fransschreuder/usbpicprog/trunk/mechanical/usbpicprog_case_bottom.stl

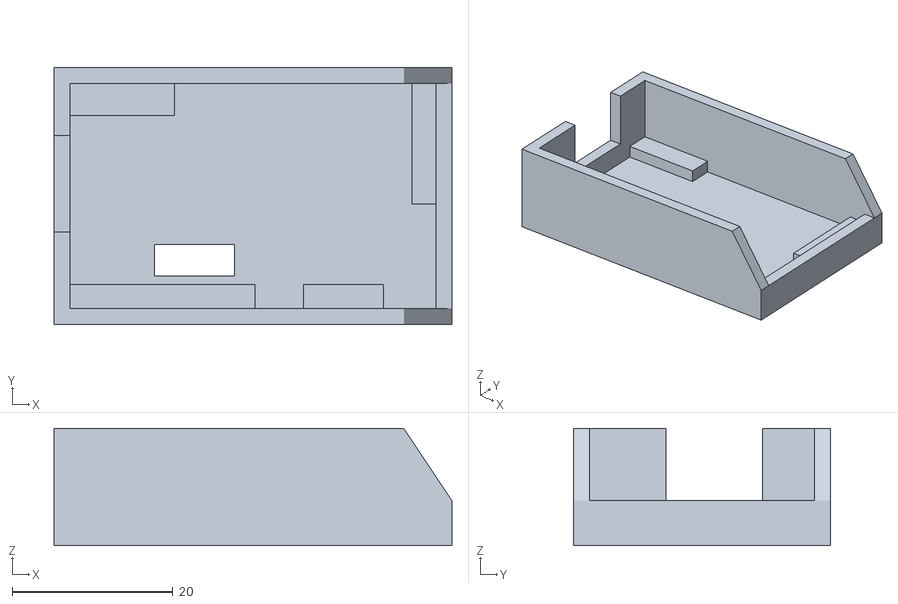
[picture p1: CAD file, 2012-11-05]
trunk/mechanical/usbpicprog_case_bottom.stl
49.5 x 32.0 x 14.6
