fransschreuder/usbpicprog/trunk/mechanical/usbpicprog_case_top.stl

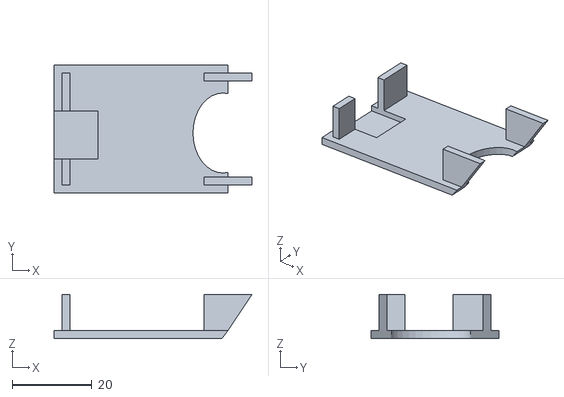
[picture p2: CAD file, 2012-11-05]
trunk/mechanical/usbpicprog_case_top.stl
49.5 x 32.0 x 11.0
