fransschreuder/usbpicprog/(threads)

Thread 8 (2014-11-26):

Error when verifying

diegoherranz, 2014-11-26:
I have an HEX file for PIC18F2550 which includes code and config (not data eeprom). Any kind of code/data/config protection is disabled.

I program the device with "Verify after programming" enabled and code, config and data verification enabled. The device is programmed correctly and the message is:
> Verify Successful

So far so good. However, if afterwards I press the "Verify" button, it fails saying:
>Verify config failed at 0x300000. Read: 0xFF, Expected: 0x00":

If I read the device back, the configration bits read are OK.

Doing some tests I noticed that the error only appears if you try to verify code and config at the same run. See this table:

| Verify Code | Verify Data | Verify Config | Result                                                       |
|:-----------:|:-----------:|:-------------:|:-------------------------------------------------------------|
|      NO     |      NO     |      YES      | Correct                                                      |
|      NO     |     YES     |       NO      | Correct                                                      |
|      NO     |     YES     |      YES      | Correct                                                      |
|     YES     |      NO     |       NO      | Correct                                                      |
|     YES     |      NO     |      YES      | Verify config failed at 0x300000. Read: 0xFF, Expected: 0x00 |
|     YES     |     YES     |       NO      | Correct                                                      |
|     YES     |     YES     |      YES      | Verify config failed at 0x300000. Read: 0xFF, Expected: 0x00 |

Then, I think that the first verification during programming works OK because code and data is verified first and config is verified later. ¿Right?

Do you have any clue where the problem is?

Thanks a lot!

PS: I noticed that using two different files, both having the same configuration bits but different code, only one of them shows this error while the other doesn't. So it seems that this bug is dependant of what's included in the code area.

PS2: usbpicprog 0.9.9-1.0.0-beta - 64 bit on Ubuntu GNOME 14.04 64 bits

diegoherranz, 2015-01-21:
Finally I had time to test with external power and everything works fine, no problems any more. So, it had to be something related with power.

It's surprising that depending on the HEX file it could fail or not.

From now on, I will always use external power.

Thanks for your help!

IMIKTechnology, 2016-06-23:
what is meant by USB error during verify

IMIKTechnology, 2016-06-23:
how i'm supposed to fix it ...?

fransschreuder, 2016-06-23:
Verify means that usbpicprog reads the code back that it just programmed, and checks it against what it just programmed. If the content doesn't match, it will tell you the address, the expected value and the read back value. It usually means that something went wrong.

IMIKTechnology, 2016-06-23:
i'm getting this error while flashing..

fransschreuder, 2016-06-23:
Of course you are, because "verify after programming" is enabled in settings.
Now what is your question?
What device are you programming?
Is your hardware normally working?

IMIKTechnology, 2016-06-23:
I'm using usbpicprog programmer...so while I try to flash i'm getting error as (USB error during verify) and also i'm getting another error followed by 1st one as (the hardware should say ok).I just want to know whether my programmer will work or not..

fransschreuder, 2016-06-23:
Ok, please just answer my questions and give some more detail as I requested. I can't help you like this.

IMIKTechnology, 2016-06-23:
i'm using usbpicprog by elementz pic programmer and flasher.http://elementzonline.com/usbpicprogrammer-by-elementz-pic-programmer-and-flasher-205?search=picprogrammer u can find in this website.I don't know whether it is working or not.When I try to burn my hex file i'm getting error what I mentioned above.

fransschreuder, 2016-06-23:
Elementz is a company that made their own board, based on usbpicprog but not the same. I had multiple questions about non-working elementz boards, and it seems crappy engineered to me.
Elementz is not at all related to usbpicprog, so please if you have malfunctioning hardware I would suggest you ask them to refund your money.
They are also violating the GPL by copying the hardware design, modifying it and not publishing the changes.

Closed 2015-01-21.

Thread 12 (2015-09-30):

Uncorrect command line

martinmikula, 2015-09-30:
I want to use a command line only interface, but it returns always 0 also in case when the command failure. (example: put wrong parameters, the program return value is 0 instead of some error code, and also a window with error appear instead of log the problem into console).

Thread 13 (2015-11-23):

Error when programming configuration bits

diegoherranz, 2015-11-23:
PIC: 18F25K22 (self-powered)
UPP sw: 0.9.9-1.0.0-beta-3
UPP fw: 1.0.0 P3
OS: Ubuntu 14.04 LTS

When loading the HEX file, on the Configuration Flags tab, I can see:

    CONFIG7L (30000Ch) = 00
    CONFIG7H (30000Dh) = 00

That means every EBTRx protection is enabled. Which is what I set on the code. So far so good.

When I try to program the device, I get an error:

    Verify config failed at 0x30000C. Read: 0x0F, Expected: 0x00

If I then read the device, the configuration flags tab says:

    CONFIG7L (30000Ch) = 0F
    CONFIG7H (30000Dh) = 40

Which confirms the error seen before.

Does it mean it isn't programming those two configuration bytes?

If I disable the EBTRx protections, it succeeds, but I guess it's because the default unprogrammed values for CONFIG7L and CONFIG7H happen to be what it's on the HEX file.

Many thanks!

Thread 16 (2018-05-31):

Slow communication

ilfirin-ms, 2018-05-31:
A have build usbpicprog v0.3hw, used 1.0.4fw and 1.0.5sw.
It's working, but painfully slow, five minutest to load and verify 117kB into PIC18F.
Looking into oscilloscope, clock are 300kHz, and communication is short (1-2ms) bursts of data at 60ms period at writing and even 100ms period at reading.
Is this normal behaviour?

Thank you

fransschreuder, 2018-05-31:
Hello ilfirin-ms.
I don't think I have often programmed a 117kB file into an 18F, but this is indeed to be expected if I scale a few seconds for a few kB .hex file to 117kB.
The PIC in the usbpicprog is not a very fast device, and probably also some of the firmware could be optimized. If you have ideas on how to improve things, your input is welcome.

ilfirin-ms, 2018-05-31:
fair enough

ilfirin-ms, 2018-06-07:
Thank you,

I wanted to use it as "independent programmer" for manufacture (to not Windows system), so commercial closed (Asix) and bloated and costy solutions (MPLAB) was not my target.

I did some research also (to build my own programmer based on your design). I would use some modern Arm chip, STM32F072, which has more power and especially, more RAM to buffer data.
Also SPI usage is important for xMHz clock, but there is a catch. I found, there have to be 20ns spaces between commands, data and more commands. This alone will make huge slowdown. Yeah, it could be maybe faster, than your solution, but I feared it wouldn't be manufacture fast enough.

I am also out of time, so probably will not build it. If time allows, I would tried to make 1$_small_F072@48Mhz_16kB_ram version with USB-CDC ascii protocol (don't like idea of making raws usb packets), but also will have slowdown with ascii translation, i know. If it would be not fast enought, port it to 10$_large_F407@168MHz_96kB_ram. If this wouldn't be either fast enough, then I am lost.

fransschreuder, 2018-06-09:
Hello Mike,
I guess you are not the only one with other priorities. I have little kids now and they take a lot of time, plus a bunch of other projects.
If somebody with fresh ideas wants to work on usbpicprog, I can make you developer as well, and even give access to the website.
I don't believe the wxWidgets loop is the problem, as the whole hex file is programmed from one while loop that is executed in a thread. There is a huge overhead of the usb library though, and that may cause some of the latency. Most of the latency is caused by the internal usb library of the PIC18F2550. This must take most of the time. Using a larger data buffer would help, but unfortunately I was unable to make this larger than a few bytes (64) or else the firmware became unstable.
Another option is not to use a microcontroller at all, but investigate the speed of the FT2232H chip. It has JTAG, SPI, I2C and some other features as well as raw bitbanging. I don't know at what speed we can bitbang there, but it may be faster than the PIC18F2550.
In that case the PIC code should be ported to the PC application, but I don't see a problem there either.

diegoherranz, 2018-06-09:
I've been using the FT2232H with OpenOCD and it works quite nice.
It's probably faster than the PIC18F2550, but I can't say for certain.

mafheldt, 2018-06-09:
Franz,

Congratulations!!! - there is nothing like kids to occupy every waking -
and sleeping! - moment.

The problem with the thread in WxWidgets is that although it was specified
to run on interrupt/realtime when it waited for the USB response from the
PIC it would wait 50ms (I spent some time trying to get around that in
2013).
I got around that but changing the protocol to send multiple 64 byte
packets to the programmer before expecting a response - that sped things up
greatly - BUT I only did it for the dsPICs/PIC24s as they were the only big
chips back then.

The PIC was not a big problem, but I sped up the programming by tweaking
the bit bang code and pretty well maxed out the programming speed. In my
email I sent I said it was 6 times faster overall - I don't remember if
that code was ever pulled into the system code, but it must still be in my
github clone of the code.

I am pretty sure that the limit at this point is the programming protocol
to the target PIC. Microchip added an "executive" are to many of the large
chips where it downloads a program, that then reads only the data from the
programmer (the current protocol is actually sending instructions and data
to the target PIC) and this would speed it up greatly

Of course these days one can buy a pickit 3 for 10 EUR on ebay.

mike

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

fransschreuder, 2018-06-09:
True, because of the price of the chinese programmers, and the availability of mplabx for linux, usbpicprog has lost quite some relevance.

mafheldt, 2018-06-09:
I have a pickit 3, mplabx is pretty crappy - but it does have breakpoints,
but I still use my usbpicprog!
I am right now updating my solar power charger for my boat and I'm using
your usbpicprog, it was a great little product

all the best
mike

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

Closed 2018-05-31.
