fransschreuder/usbpicprog/trunk/pcb/usbpicprog.pdf

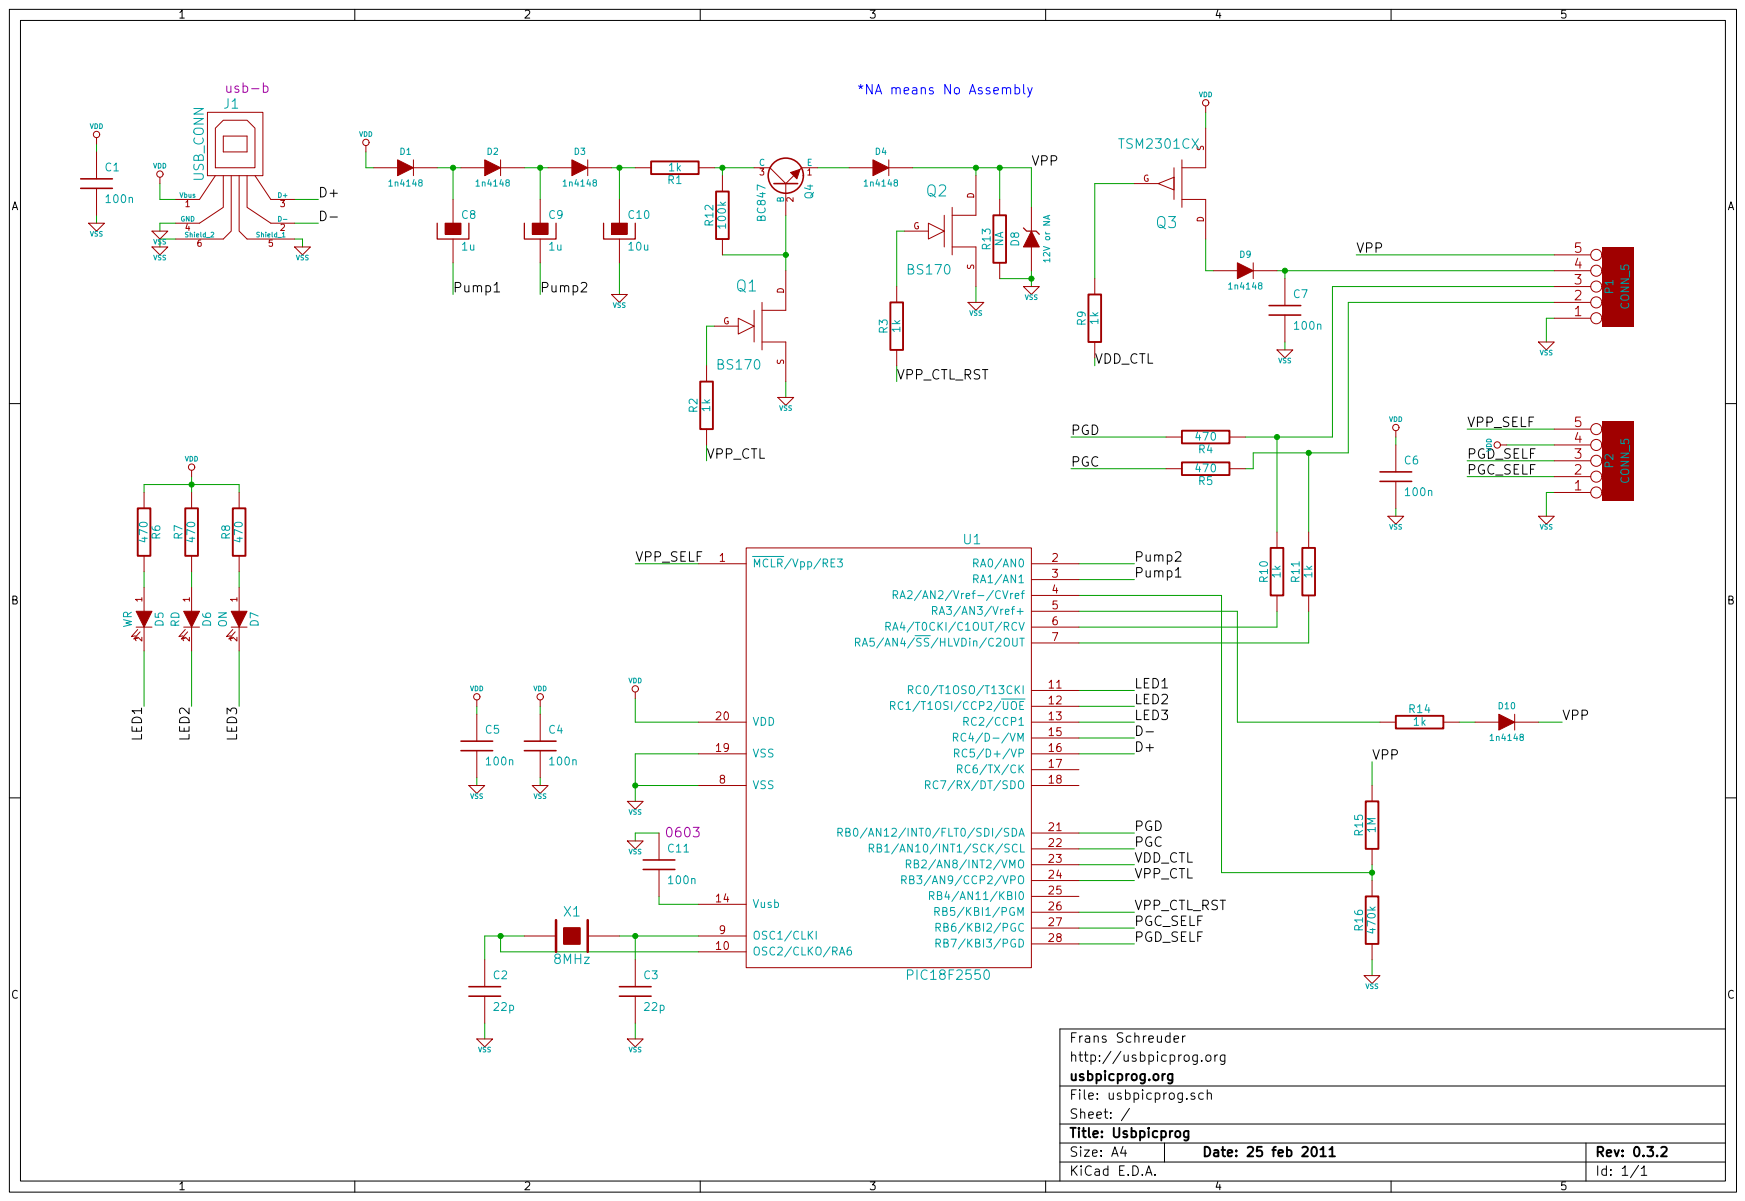
[picture p3: page 1]
