fransschreuder/usbpicprog/trunk/pcb/usbpicprog_th.pdf

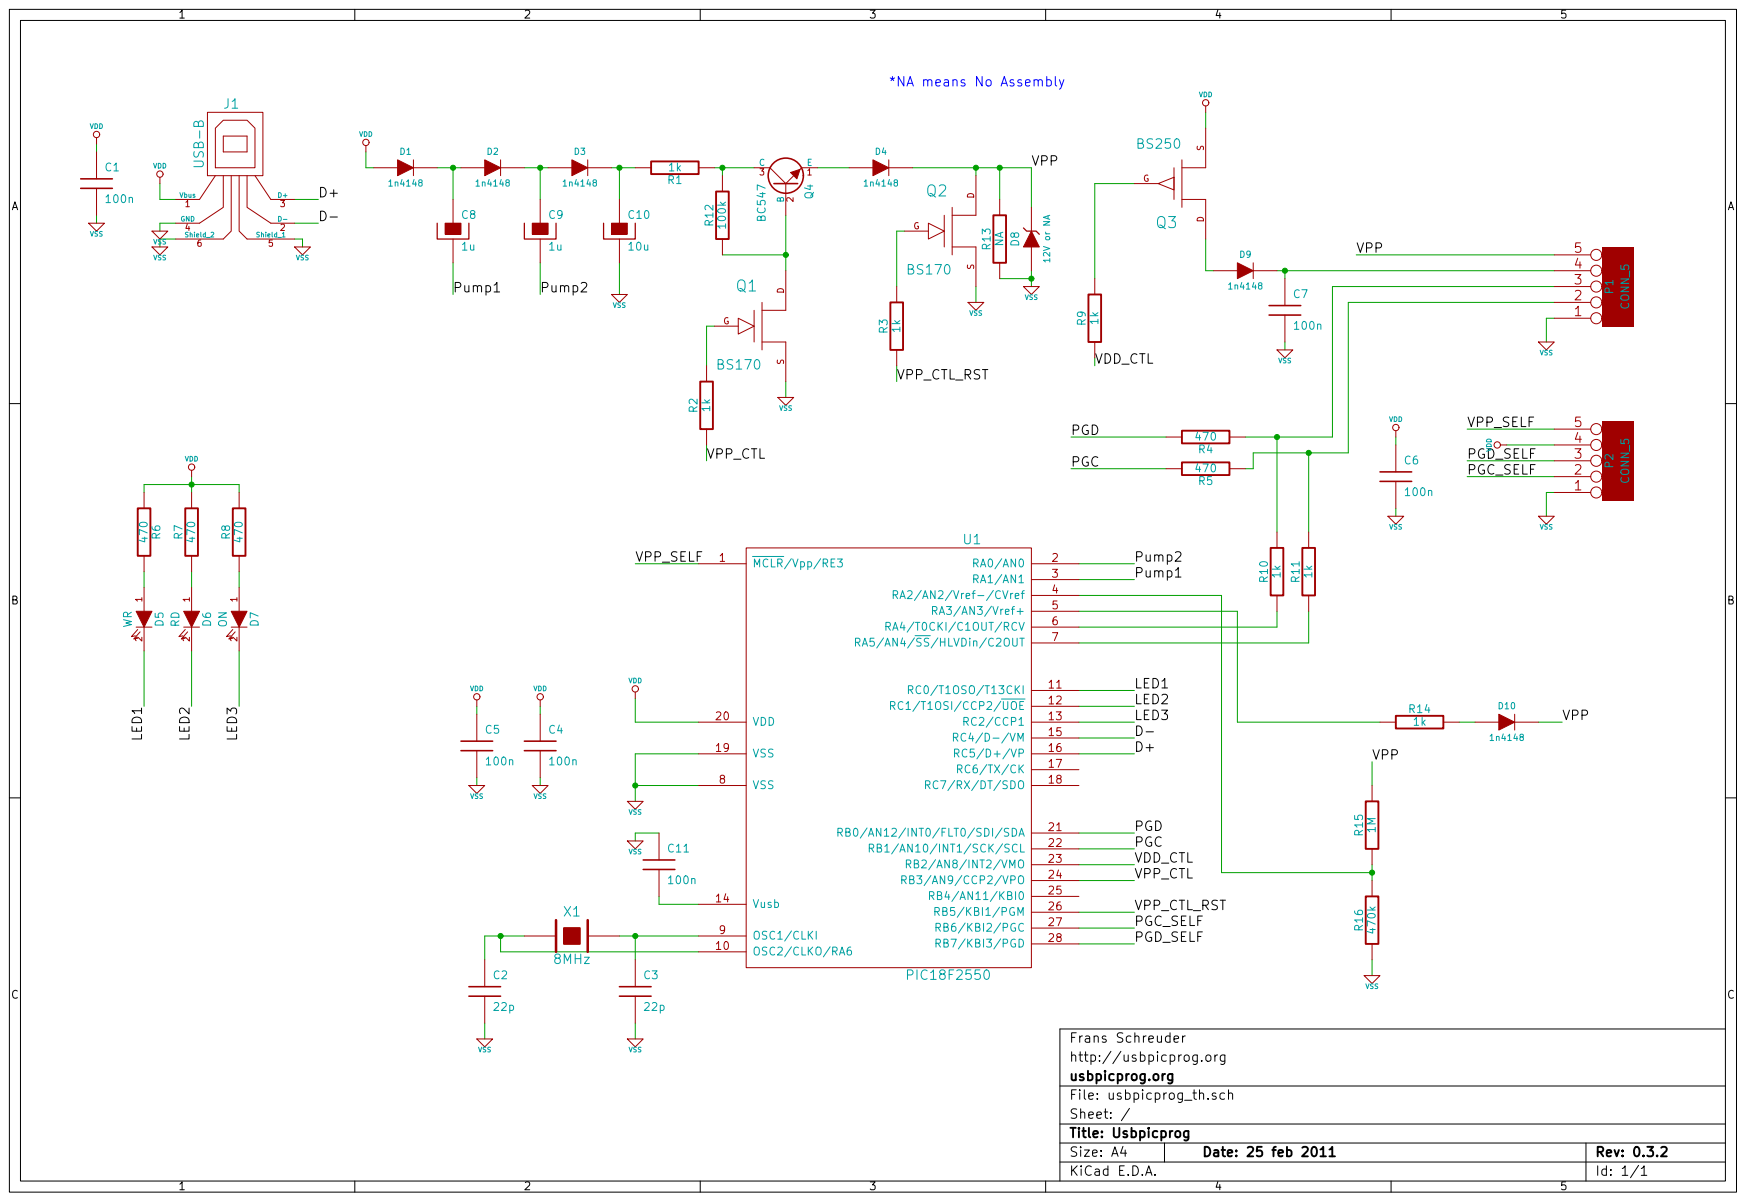
[picture p4: page 1]
