fransschreuder/usbpicprog/trunk/pcb/usbpicprog.sch

## KiCad design trunk/pcb/usbpicprog.sch (2013-02-21, an earlier design)

Schematic: usbpicprog.sch

Parts:
C1, C4, C5, C6, C7: 100n
C2, C3: 22p
C8, C9: 1u
C10: 10u
C11: 100n; 0603
D1, D2, D3, D4, D9, D10: 1n4148
D5: WR
D6: RD
D7: ON
D8: 12V or NA
J1: USB_CONN; usb-b
P1, P2: CONN_5
Q1, Q2: BS170
Q3: TSM2301CX
Q4: BC847
R1, R2, R3, R9, R10, R11, R14: 1k
R4, R5, R6, R7, R8: 470
R12: 100k
R13: NA
R15: 1M
R16: 470k
U1: PIC18F2550
X1: 8MHz

Notes on the sheet:
*NA means No Assembly
