fransschreuder/usbpicprog/trunk/uc_code/upp.c

/**************************************************************************
 *   Copyright (C) 2008 by Frans Schreuder                                 *
 *   usbpicprog.sourceforge.net                                            *
 *                                                                         *
 *   This program is free software; you can redistribute it and/or modify  *
 *   it under the terms of the GNU General Public License as published by  *
 *   the Free Software Foundation; either version 2 of the License, or     *
 *   (at your option) any later version.                                   *
 *                                                                         *
 *   This program is distributed in the hope that it will be useful,       *
 *   but WITHOUT ANY WARRANTY; without even the implied warranty of        *
 *   MERCHANTABILITY or FITNESS FOR A PARTICULAR PURPOSE.  See the         *
 *   GNU General Public License for more details.                          *
 *                                                                         *
 *   You should have received a copy of the GNU General Public License     *
 *   along with this program; if not, write to the                         *
 *   Free Software Foundation, Inc.,                                       *
 *   59 Temple Place - Suite 330, Boston, MA  02111-1307, USA.             *
 **************************************************************************/

#ifdef __XC8
#include <xc.h>
#elif defined(SDCC)
#include <pic18f2550.h>
#else
#include <p18cxxx.h>
#endif

#include "typedefs.h"
#include "usb.h"

#include "io_cfg.h"             // I/O pin mapping
#include "upp.h"
#include <string.h>
#include "prog.h"
#include "prog_lolvl.h"
#include "svn_revision.h"
#include "interrupt.h"
#include "main.h"
#include "debug_link.h"

/** V A R I A B L E S ********************************************************/
#ifndef SDCC
#pragma udata
#endif
byte old_sw2, old_sw3;

// FIXME: why 0x100?
#pragma udata BUFFERS=0x100

byte input_buffer[USBGEN_EP_SIZE];
byte output_buffer[USBGEN_EP_SIZE];
#pragma udata

extern unsigned char ConfigDisableVDD;
extern unsigned char ConfigLimitVPP;
extern unsigned char ConfigLimitPGDPGC;

rom char upp_version[] = {
		SVN_REVISION };

// Programming mode is left after this long without a command from the host.
// Within a session the host sends its blocks back to back, and the timer is
// restarted after every command, so slow commands (erase, word-by-word
// writes) don't count towards it.
#define ISCP_IDLE_TIMEOUT_MS	5000

/** P R I V A T E  P R O T O T Y P E S ***************************************/
void BlinkUSBStatus( void );
BOOL Switch2IsPressed( void );
BOOL block_size_ok( int nBytes );

void setLeds( char n );

/** D E C L A R A T I O N S **************************************************/
#ifndef SDCC
#pragma code
#endif

void InitAdc( void )
{
	ADCON0 = 0x09; //Enable AD converter to Channel AN2 (measure VPP);
	ADCON2 = 0xA6; //0x88		//Right justified, 2TAD, Fosc/2
	ADCON1 = 0x0F; //All signals to Digital
	TRISAbits.TRISA2 = 1; //Input;
}

void ReadAdc( unsigned char* data )
{
	char i;
	i = 0;
	ADCON1 = 0x0C; //channel AN2 .. AN0 to analog
	ADCON0bits.GO = 1;
	while( ADCON0bits.GO )
		continue;//||(i++<100))continue;
	data[0] = ADRESL;
	data[1] = ADRESH;
	ADCON1 = 0xFF; //back to digital...
}

void UserInit( void )
{
	mInitAllLEDs();
	mInitAllSwitches();
	InitAdc();
	old_sw2 = sw2;
	Pump1tris = 0;
	Pump2tris = 0;

	TRISVPP = 0; //output
	TRISVPP_RST = 0; //output
	TRISPGD = 0;
	TRISPGC = 0;
	TRISVDD = 0;
	TRISVPP_RUN = 0;
	VPP_RUN = 0; //run = off
	PGD_LOW = 0;	// always set to 0 -except for I2C EEproms
	TRISPGD_LOW = 1; //LV devices disabled, high impedance / input
	PGC_LOW = 0;	// always set to 0
	TRISPGC_LOW = 1; //LV devices disabled, high impedance / input
	VPP = 1; //VPP is low (inverted)
	VPP_RST = 0; //No hard reset (inverted
	PGD = 0;
	PGC = 0;
	INTCON2bits.RBPU = 1; //disable Portb pullup resistors
	timer1Init();
	timer0Init();
}//end UserInit

void timer1Init( void )
{
	INTCON |= 0xC0; //global and periferal interrupts enabled
	PIE1bits.TMR1IE = 1;//enable timer1 interrupt
	PIR1bits.TMR1IF = 0;//clear interrupt flag
	IPR1bits.TMR1IP = 1;//high priority interrupt
	TMR1H = TMR1H_PRESET;
	TMR1L = TMR1L_PRESET;
	T1CON = 0x01; //timer1 on, prescaler 1;1, internal clock
}

void timer0Init( void )
{
	INTCON |= 0xE0; //global, periferal and t0ie bits enabled
	INTCONbits.TMR0IF = 0; //clear interrupt flag
	TMR0L = 68;//TMR0L_PRESET;
	T0CON = 0xC3; //prescaler div by 1:16
}

void setLeds( char n )
{
	mLED_1 = ~(n & 1);
	mLED_2 = ~((n & 2) >> 1);
	mLED_3 = ~((n & 4) >> 2);
}

/******************************************************************************
 * Function:        void ProcessIO(void)
 *
 * PreCondition:    None
 *
 * Input:           None
 *
 * Output:          None
 *
 * Side Effects:    None
 *
 * Overview:        This function is a place holder for other user routines.
 *                  It is a mixture of both USB and non-USB tasks.
 *
 * Note:            None
 *****************************************************************************/

//unsigned int input_buffer_offset=0;

void ProcessIO( void )
{
	char oldPGDtris;
	char PIN;
	static byte counter = 0;
	int nBytes;
	unsigned long address;
	static int isReading = 0;
	unsigned int idle;

	// Leave programming mode when the host has abandoned a session (crashed,
	// timed out, unplugged from the PC side), instead of leaving VPP and VDD
	// on the target indefinitely.
	if( iscp_active )
	{
		INTCONbits.GIE = 0;	// read the ISR's 16-bit counter in one piece
		idle = idleMs;
		INTCONbits.GIE = 1;
		if( idle > ISCP_IDLE_TIMEOUT_MS )
		{
			exit_ISCP();
			isReading = 0;
		}
	}

	// When the device is plugged in, the leds give the numbers 1, 2, 3, 4, 5.
	//After configured state, the leds are controlled by the next lines in this function
	if( usb_device_state < CONFIGURED_STATE )
	{
		// A bus reset or deconfiguration ends the host's session: drop any
		// reply or multi-block read that belongs to it.
		counter = 0;
		isReading = 0;
	}
	if( (usb_device_state < CONFIGURED_STATE) || (UCONbits.SUSPND == 1) )
	{
		BlinkUSBStatus();
		return;
	}

	// Exactly one reply per command, in order: while the host has not taken
	// the previous reply, don't accept a new command (the OUT endpoint NAKs).
	// Dropping the reply instead made the host read every later reply one
	// command late.
	if( counter != 0 )
	{
		if( mUSBGenTxIsBusy() )
			return;
		USBGenWrite( (byte*) &output_buffer, counter );
		counter = 0;
	}

	nBytes = USBGenRead( (byte*) input_buffer, 64 );
	if( nBytes > 0 )
		isReading = 0;	// a new command ends an unfinished multi-block read
	if( nBytes == 0 && !mUSBGenTxIsBusy() && isReading
	 || nBytes > 0 )
	{
		idleMs = 0;	// the host is active (a command, or the next block of a multi-block read)
		if( nBytes > 0 && !block_size_ok( nBytes ) )
		{
			output_buffer[0] = 3;
			counter = 1;
		}
		else switch( input_buffer[0] ) {
		case CMD_GET_PROTOCOL_VERSION:
			output_buffer[0] = PROT_UPP;		// see upp.h
			counter = 1;
			break;
		case CMD_EXIT_TO_BOOTLOADER:
			exitToBootloader( 1 );		// if this returns -> bad bootloader version, return error
			// blink for 2s: stay under the host's 3s timeout so the error reply
			// arrives while the host is still waiting for it
			for( counter = 0; counter < 5; counter++ )
			{
				setLeds(7);
				DelayMs( 200 );
				setLeds( 0 );
				DelayMs( 200 );
			}
			output_buffer[0] = 3;
			counter = 1;
			break;
		case CMD_ERASE:
			setLeds( LEDS_ON | LEDS_WR );
			output_buffer[0] = bulk_erase( input_buffer[1] );
			counter = 1;
			setLeds( LEDS_ON );
			break;
		case CMD_READ_ID:
			setLeds( LEDS_ON | LEDS_RD );
			output_buffer[0] = 0;	// families without a device ID reply 0x0000
			output_buffer[1] = 0;
			switch( picfamily ) {
			case PIC24:
			case dsPIC30:
				read_code( 0xFF0000, (unsigned char*) output_buffer, 2, BLOCKTYPE_FIRST|BLOCKTYPE_LAST|BLOCKTYPE_CONFIG );
				break;
			case PIC18:
			case PIC18J:
			case PIC18K:
				//devid is at location 0x3ffffe   for PIC18 devices
				read_code( 0x3FFFFE, (unsigned char*) output_buffer, 2, BLOCKTYPE_FIRST|BLOCKTYPE_LAST|BLOCKTYPE_CONFIG );
				break;
			case PIC16:
				exit_ISCP();
				//devid is at location 0x2006  for PIC16 devices
				read_code( 0x2006, (unsigned char*) output_buffer, 2, BLOCKTYPE_FIRST|BLOCKTYPE_LAST|BLOCKTYPE_CONFIG );
				break;
			}
			counter = 2;
			setLeds( LEDS_ON );
			break;
		case CMD_WRITE_CODE:
			setLeds( LEDS_ON | LEDS_WR );
			address = ((unsigned long) input_buffer[2]) << 16 | ((unsigned long) input_buffer[3]) << 8
					| ((unsigned long) input_buffer[4]);
			output_buffer[0] = write_code( address,
					(unsigned char*) (input_buffer + 6), input_buffer[1], input_buffer[5] );
			counter = 1;
			setLeds( LEDS_ON );
			break;
		case CMD_READ_CONFIG:
			input_buffer[5] |= BLOCKTYPE_CONFIG;
			// no break
		case CMD_READ_CODE_OLD:
			if( input_buffer[1] <= 8 )		// this is correct for all but PIC18F4321(?) where it doesn't matter
				input_buffer[5] |= BLOCKTYPE_CONFIG;
		case CMD_READ_CODE:
			setLeds( LEDS_ON | LEDS_RD );

			address = ((unsigned long) input_buffer[2]) << 16 | ((unsigned long) input_buffer[3]) << 8
					| ((unsigned long) input_buffer[4]);
			read_code( address, (unsigned char*) output_buffer, input_buffer[1], input_buffer[5] );
			counter = input_buffer[1];
			setLeds( LEDS_ON );
			break;
        case CMD_MREAD_CODE:
            setLeds( LEDS_ON | LEDS_RD );

            address = ((unsigned long) input_buffer[2]) << 16 | ((unsigned long) input_buffer[3]) << 8
                    | ((unsigned long) input_buffer[4]);
            read_code( address, (unsigned char*) output_buffer, input_buffer[1], input_buffer[5] );
            if( --input_buffer[7] == 255 )
                --input_buffer[6];
            if( input_buffer[6] == 0 && input_buffer[7] == 0 )
                isReading = 0;
            else
                isReading = 1;
            if( picfamily == PIC10
             || picfamily == PIC12
             || picfamily == PIC16 )
                address += input_buffer[1]/2;
            else
                address += input_buffer[1];
            input_buffer[4] = address;
            input_buffer[3] = address >> 8;
            input_buffer[2] = address >>16;
            counter = input_buffer[1];
            setLeds( LEDS_ON );
            break;
		case CMD_WRITE_DATA:
			setLeds( LEDS_ON | LEDS_WR );
			address = ((unsigned long) input_buffer[2]) << 16 | ((unsigned long) input_buffer[3]) << 8
					| ((unsigned long) input_buffer[4]);
			output_buffer[0] = write_data( address,
					(unsigned char*) (input_buffer + 6), input_buffer[1], input_buffer[5] );
			counter = 1;
			setLeds( LEDS_ON );
			break;
		case CMD_READ_DATA:
			setLeds( LEDS_ON | LEDS_RD );
			address = ((unsigned long) input_buffer[2]) << 16 | ((unsigned long) input_buffer[3]) << 8
					| ((unsigned long) input_buffer[4]);
			read_data( address, (unsigned char*) output_buffer, input_buffer[1],
					input_buffer[5] );
			counter = input_buffer[1];
			setLeds( LEDS_ON );
			break;
		case CMD_WRITE_CONFIG:
			setLeds( LEDS_ON | LEDS_WR );
			address = ((unsigned long) input_buffer[2]) << 16 | ((unsigned long) input_buffer[3]) << 8
					| ((unsigned long) input_buffer[4]);
			output_buffer[0] = write_config_bits( address,
					(unsigned char*) (input_buffer + 6), input_buffer[1], input_buffer[5] );
			counter = 1;
			setLeds( LEDS_ON );
			break;
		case CMD_SET_PICTYPE:
		{
			int i;

			output_buffer[0] = set_pictype( input_buffer[1] );
			counter = 1;
			setLeds( LEDS_ON );
			break;
		}
		case CMD_FIRMWARE_VERSION:
#ifdef __XC8
			strcpy((char*)output_buffer,upp_version);
#else
			strcpypgm2ram((char*)output_buffer,(const far rom char*)upp_version);
#endif
			counter = 18;
			setLeds( LEDS_ON );

			break;
		case CMD_DEBUG:
			setLeds( LEDS_ON | LEDS_WR | LEDS_RD );
			switch( input_buffer[1] ) {
			case 0:
				set_pictype( dsP30F );
				enter_ISCP();
				output_buffer[0] = 1;
				counter = 1;
				break;
			case 1:
				exit_ISCP();
				output_buffer[0] = 1;
				counter = 1;
				break;
			case 2:
				dspic_send_24_bits( ((unsigned long) input_buffer[2])
						| ((unsigned long) input_buffer[3]) << 8
						| ((unsigned long) input_buffer[4]) << 16 );
				output_buffer[0] = 1;
				counter = 1;
				break;
			case 3:
				nBytes = dspic_read_16_bits( 1 );
				output_buffer[0] = (unsigned char) nBytes;
				output_buffer[1] = (unsigned char) (nBytes >> 8);
				counter = 2;
				break;
			default:
				output_buffer[0] = 3;
				counter = 1;
				break;
			}
			break;
		case CMD_GET_PIN_STATUS:
			switch( input_buffer[1] ) {
			case SUBCMD_PIN_PGC:

				if( PGC == 0 )
					output_buffer[0] = PIN_STATE_0V;
				else if( (!TRISPGC_LOW) ) //3.3V levels
					output_buffer[0] = PIN_STATE_3_3V;
				else
					output_buffer[0] = PIN_STATE_5V;
				counter = 1;
				break;
			case SUBCMD_PIN_PGD:
				if( PGD == 0 )
					output_buffer[0] = PIN_STATE_0V;
				else if( (!TRISPGD_LOW) ) //3.3V levels
					output_buffer[0] = PIN_STATE_3_3V;
				else
					output_buffer[0] = PIN_STATE_5V;
				counter = 1;
				break;
			case SUBCMD_PIN_VDD:
				if( VDD )
					output_buffer[0] = PIN_STATE_FLOAT;
				else
					output_buffer[0] = PIN_STATE_5V;
				counter = 1;
				break;
			case SUBCMD_PIN_VPP:
				counter = 1;
				if( !VPP )
				{
					output_buffer[0] = PIN_STATE_12V;
					break;
				}
				if( VPP_RST )
				{
					output_buffer[0] = PIN_STATE_0V;
					break;
				}
				if( VPP_RUN )
				{
					output_buffer[0] = PIN_STATE_5V;
					break;
				}
				output_buffer[0] = PIN_STATE_FLOAT;
				break;
			case SUBCMD_PIN_VPP_VOLTAGE:
				ReadAdc( output_buffer );
				counter = 2;
				break;
			default:
				output_buffer[0] = 3;
				counter = 1;
				break;
			}
			break;
		case CMD_SET_PIN_STATUS:
			switch( input_buffer[1] ) {
			case SUBCMD_PIN_PGC:
				switch( input_buffer[2] ) {
				case PIN_STATE_0V:
					TRISPGC = 0;
					PGC = 0;
					TRISPGC_LOW = 1;
					PGC_LOW = 0;
					output_buffer[0] = 1;//ok
					break;
				case PIN_STATE_3_3V:
					TRISPGC = 0;
					PGC = 1;
					TRISPGC_LOW = 0;
					PGC_LOW = 0;
					output_buffer[0] = 1;//ok
					break;
				case PIN_STATE_5V:
					TRISPGC = 0;
					PGC = 1;
					TRISPGC_LOW = 1;
					PGC_LOW = 0;
					output_buffer[0] = 1;//ok
					break;
				default:
					output_buffer[0] = 3;
					break;
				}
				break;
			case SUBCMD_PIN_PGD:
				switch( input_buffer[2] ) {
				case PIN_STATE_0V:
					TRISPGD = 0;
					PGD = 0;
					TRISPGD_LOW = 1;
					PGD_LOW = 0;
					output_buffer[0] = 1;//ok
					break;
				case PIN_STATE_3_3V:
					TRISPGD = 0;
					PGD = 1;
					TRISPGD_LOW = 0;
					PGD_LOW = 0;
					output_buffer[0] = 1;//ok
					break;
				case PIN_STATE_5V:
					TRISPGD = 0;
					PGD = 1;
					TRISPGD_LOW = 1;
					PGD_LOW = 0;
					output_buffer[0] = 1;//ok
					break;
				case PIN_STATE_INPUT:
					TRISPGD_LOW = 1;
					TRISPGD = 1;
					output_buffer[0] = 1;//ok
					break;
				default:
					output_buffer[0] = 3;
					break;
				}
				break;
			case SUBCMD_PIN_VDD:
				switch( input_buffer[2] ) {
				case PIN_STATE_5V:
					VDD = 0;
					output_buffer[0] = 1;
					break;
				case PIN_STATE_FLOAT:
					VDD = 1;
					output_buffer[0] = 1;
					break;
				default:
					output_buffer[0] = 3;
					break;
				}
				break;
			case SUBCMD_PIN_VPP:
				// break before make: switch the other VPP sources off first
				switch( input_buffer[2] ) {
				case PIN_STATE_0V:
					VPP = 1;
					VPP_RUN = 0;
					VPP_RST = 1;
					output_buffer[0] = 1;//ok
					break;
				case PIN_STATE_5V:
					VPP = 1;
					VPP_RST = 0;
					VPP_RUN = 1;
					output_buffer[0] = 1;//ok
					break;
				case PIN_STATE_12V:
					if( ConfigLimitVPP )
					{
						output_buffer[0] = 3;	// VPP is limited to 5V
						break;
					}
					VPP_RST = 0;
					VPP_RUN = 0;
					VPP = 0;
					output_buffer[0] = 1;//ok
					break;
				case PIN_STATE_FLOAT:
					VPP = 1;
					VPP_RST = 0;
					VPP_RUN = 0;
					output_buffer[0] = 1;//ok
					break;
				default:
					output_buffer[0] = 3;
					break;
				}
				break;
			default:
				output_buffer[0] = 3;
			}
			counter = 1;
			break;
		case CMD_APPLY_SETTINGS:
			if(input_buffer[1]&CONFIG_DISABLE_VDD_MASK)
				ConfigDisableVDD=1;
			else
				ConfigDisableVDD=0;
			if(input_buffer[1]&CONFIG_LIMIT_VPP_MASK)
				ConfigLimitVPP=1;
			else
				ConfigLimitVPP=0;
			if(input_buffer[1]&CONFIG_LIMIT_PGDPGC_MASK)
				ConfigLimitPGDPGC=1;
			else
				ConfigLimitPGDPGC=0;
			output_buffer[0]=1;
			counter=1;
			break;
		case CMD_DEBUG_LINK:
			setLeds( LEDS_ON | LEDS_RD );
			counter = debug_link( input_buffer, output_buffer, nBytes );
			setLeds( LEDS_ON );
			break;
		default:
			output_buffer[0] = 3;			// unrecognized command
			counter = 1;
		}
	}
	if( counter != 0 )
		idleMs = 0;	// restart the idle timer after the command, however long it took
	if( counter != 0 && !mUSBGenTxIsBusy() )
	{
		USBGenWrite( (byte*) &output_buffer, counter );
		counter = 0;
	}
	// otherwise the reply is sent by the next call, before a new command is read
}//end ProcessIO

/******************************************************************************
 * Check the block size in a command packet against the 64-byte USB packets,
 * so that a bad or malicious host cannot make the firmware read past
 * input_buffer or write past output_buffer. nBytes is the packet length.
 *****************************************************************************/
BOOL block_size_ok( int nBytes )
{
	switch( input_buffer[0] ) {
	case CMD_WRITE_CODE:
	case CMD_WRITE_DATA:
	case CMD_WRITE_CONFIG:
		return input_buffer[1] <= USBGEN_EP_SIZE - 6 && nBytes >= input_buffer[1] + 6;
	case CMD_MREAD_CODE:
		if( input_buffer[6] == 0 && input_buffer[7] == 0 )
			return FALSE;	// a count of 0 would wrap around to 65535 blocks
		// no break
	case CMD_READ_CODE:
	case CMD_READ_CONFIG:
	case CMD_READ_CODE_OLD:
	case CMD_READ_DATA:
		return input_buffer[1] <= USBGEN_EP_SIZE;
	default:
		return TRUE;
	}
}

unsigned char set_pictype( unsigned char pt )
{
	unsigned char i;

	pictype = pt;
	for( i = 0; i < devices_count; i++ )
	{
		if( devices[i].flags.type == pt )
		{
			currDevice = devices[i];
			break;
		}
	}

	if( i < devices_count && currDevice.flags.family != UPP_INVALID_PICFAMILY )
	{
		picfamily = currDevice.flags.family;
		return (1);
	}
	// Unknown or disabled type: select no algorithm at all, so reads return
	// zeros and writes/erases reply 3 without touching the target. Before
	// 1.1.0 this fell back to P18F2XXX, and hosts that ignore this reply
	// (such as the original PC software) went on to apply its 12V entry to
	// whatever was connected, e.g. a 3.3V PIC24 during autodetection.
	for( i = 0; i < sizeof( currDevice ); i++ )
		((unsigned char *) &currDevice)[i] = 0;
	pictype = UPP_INVALID_PICTYPE;
	picfamily = UPP_INVALID_PICFAMILY;
	return( 3 );
}

	/******************************************************************************
 * Function:        void BlinkUSBStatus(void)
 *
 * PreCondition:    None
 *
 * Input:           None
 *
 * Output:          None
 *
 * Side Effects:    None
 *
 * Overview:        BlinkUSBStatus turns on and off LEDs corresponding to
 *                  the USB device state.
 *
 * Note:            mLED macros can be found in io_cfg.h
 *                  usb_device_state is declared in usbmmap.c and is modified
 *                  in usbdrv.c, usbctrltrf.c, and usb9.c
 *****************************************************************************/
void BlinkUSBStatus( void )
{
	static word led_count = 0;
	static char startup_state = 0xFF;

	if( led_count == 0 )
		led_count = 10000U;
	led_count--;

	if( UCONbits.SUSPND == 1 )
	{
		//USBWakeFromSuspend();
		if( led_count == 0 )
		{
			mLED_1_Off();
			mLED_2_Off();
			mLED_3_Toggle();
		}//end if
	}
	else
	{
		if( usb_device_state == DETACHED_STATE )
		{
			setLeds( 1 );
		}
		else if( usb_device_state == ATTACHED_STATE )
		{
			setLeds( 2 );
		}
		else if( usb_device_state == POWERED_STATE )
		{
			setLeds( 4 );
		}
		else if( usb_device_state == DEFAULT_STATE )
		{
			setLeds( 2 );
		}
		else if( usb_device_state == ADDRESS_STATE )
		{
			setLeds( LEDS_ON );
		}
		else if( usb_device_state == CONFIGURED_STATE )
		{
			startup_state = 0;
		}
	}
}

BOOL Switch2IsPressed( void )
{
	if( sw2 != old_sw2 )
	{
		old_sw2 = sw2; // Save new value
		if( sw2 == 0 ) // If pressed
			return TRUE; // Was pressed
	}
	return FALSE; // Was not pressed
}//end Switch2IsPressed


/** EOF upp.c ***************************************************************/
