fransschreuder/usbpicprog/(commit log)

2007-06-15 Updated pad sizes of connectors
    [usbpicprog.brd]
2007-06-22 Shut timer1 off in boot_main.c
2007-06-25 added the right leds to the uc_code
2007-06-26 added struct PORTCbits.LEDS to upp.h
2007-06-27 added the fucntion reset_usb(void) to main.c to reset the usb module after boot. (It might have been initialized by the bootloader...)
    [main.c]
2007-06-28 Fixed a bug according to: http://ww1.microchip.com/download/en/DeviceDoc/80220f.pdf bug 10
    [usbctrltrf.c]
2007-06-29 added Leds struct to upp.c
2007-07-02 added voltage pump
2007-07-09 added VPP PGD PGC etc...
    [usbpicprog.sch]
2007-07-11 fixed some issues to convert the USBrs232 version to the usbgen version
    [upp.c]
2007-09-18 -changed the device ID from 0x000C to 0x000E (it's not an Microchip USB Demo anymore) -also uncommented the line to enter usb sleep in usbdrv.c
2007-09-22 Can now set leds by running "fsusb_demo n"
2007-09-22 changed C11 from 47uF 1206 to 100nF 0603 in PCB and Schematic
    [usbpicprog.brd, usbpicprog.sch]
2007-10-20 -added all the functions (but not yet implemented everything) to upp.cpp -added the line for "Usbpicprog" in direct_prog_config.cpp
    *****PIKLAB NOW COMPILES WITH THE DRIVER!!!*****
2007-10-22 -Usbpicprog is now communicating with Piklab (need to change the some small things in the Piklab driver) -changed the pinout in direct_prog_config
2007-10-23 *added the function to switch VDD on the ICSP header *Routing not completed yet *Added PCB v0.1 (the old version)
    [$savepcb.brd, usbpicprog.brd, usbpicprog.sch, usbpicprog_0.1.brd]
2007-10-23 some fixes due to revision #100
    [upp.h]
2007-10-23 resolved bug - pin values in upp.c were 1 to high
    [upp.c]
2007-10-25 added schematic in png format
2007-10-25 updated PCB v0.2
    [$savepcb.brd, usbpicprog.brd, usbpicprog.sch]
2007-10-27 changed time base of voltage pump added gerber files added groundplane to the PCB
    [usbpicprog.brd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]
2007-10-27 voltage pump is now handled from timer1 interrupt changed the read_pin cycle, will now return 0xC3 for PGD=0 and 0xD3 for PGD=1 (0xC for read, bit4 is the value and 0x03 means pin3 which is PGD_READ)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
2007-11-07 added signal names of program header to the silkscreen
    [usbpicprog.brd]
2007-11-07 changed some things on the silkscreen and make ready to order
    [usbpicprog.brd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]
2007-11-07 copied release 0.2 of the pcb to release/pcb_0_2
    [$savepcb.brd, usbpicprog.brd, usbpicprog.sch, usbpicprog_0.1.brd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]
2007-11-19 adapted the piklab driver to some changes in the piklab source code, for example: Port::ParallelType is now PortType::Parallel and Port::Type is now the class PortType
2007-11-19 deleted the old piklab, it's now replaced with piklab_r2537
    This line, and those below, will be ignored--
    D piklab
    [main.cpp, main.h, upp.h]
2007-11-20 worked on SDCC port for uc_code (still not working)
    [interrupt.h, io_cfg.h, main.c, typedefs.h]
2007-11-27 added the crystal low-profile to the pcb 3d view again (don't know why it was lost)
    [usbpicprog.brd]
2007-12-07 added bill of materials to the pcb
    [bom.xls]
2007-12-07 bill of materials
    [bom.xls]
2007-12-09 added a board for the zif socket - still need to add the footprint for 40 pin PIC (is now tqfp package)
    [zif_socket.brd, zif_socket.sch]
2008-02-19 added microchip programming document
    [$savepcb.brd, zif_socket.brd, zif_socket.sch]
2008-02-19 Add programmer class, with a dependances on LibUsb++, which will be the interface with the board
2008-02-22 Organized the SVN into a standard directory structure with trunk, tags, branches
    [$savepcb.brd, bom.xls, usbpicprog.brd, usbpicprog.sch, usbpicprog_0.1.brd, zif_socket.brd, zif_socket.sch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]
2008-02-25 implemented all low level functions for pic18 programming for all pic18F2xxx / 4xxx devices (still untested)
2008-02-27 inserted some test calls in upp.c. when the pc sends "t", it will try to erase a pic18
2008-02-28 fixed some typo's in upp.c
    [upp.c]
2008-02-29 does compile now, still not erasing the device :(
2008-02-29 added program_erase but it still doesn't work :(
    [main.c, prog.h, upp.c]
2008-02-29 getiing the device id
2008-03-01 fixed a bug in the uc_code_old_bitbang, (added counter=0) this bug caused the usbpicprog to send its data twice or even more
    [upp.c]
2008-03-02 fixed delays in set_vdd_vpp() get DEVID and bulk_erase are now working!
    [upp.c]
2008-03-03 Added supported_devices.ods, also on the website
    [supported_devices.ods]
2008-03-05 updated supported devices with 18Fxx2, xx8
    [supported_devices.ods]
2008-03-05 fixed some compiling issues
    [prog.h, upp.c]
2008-03-06 changed some compile bugs implemented read_config (in pc app)
    [upp.c]
2008-03-08 read and write data works now, except one bug: -after write_data, read data fails once (also other reads will fail once)
    [prog.h, upp.c]
2008-03-09 fixed some errors in write_code, write_data and write_config_bits
    everything from the pic18F2550 can now be read and written by the uc_code!
    remaining issue: after a write_data, the next readout will fail.
    [prog.h, upp.c]
2008-03-09 updated supported_devices.ods (also updated it on the website)
    [supported_devices.ods]
2008-03-10 implemented read_version (it produces some corrupted string now...)
    [supported_devices.ods]
2008-03-11 moved 16F628 to current
2008-03-11 added the PIC16F62XA / PIC16F648A to supported devices
    [supported_devices.ods]
2008-03-12 restructured the low level functions into prog_lolvl.c / .h ***if you want to test PIC18F2xxx / 18F4xxx devices, checkout the previous revision (r192)***
2008-03-12 moved the variable lasttick to interrupt.c
2008-03-12 added DelayMs in interrupt.c implemented set_pic_type, the numbers for this are still on TBD in the protocol, so expect changes (this is for testing only)moved the variable lasttick to interrupt.c
2008-03-12 fixed some compile bugs
    [prog.h, prog_lolvl.c, prog_lolvl.h, upp.c, upp.h]
2008-03-12 added implementation for the dropdown box to select a pic PIC16F628 can now be programmed (functions were intended to be for 628A)
    [supported_devices.ods]
2008-03-12 added PIC16F62X prog spec to current devices
2008-03-14 *Got rid of all the state machines *Got rid of most double pictype / picvariant switches *Cleaned up code
2008-03-31 updated supported devices.ods for the 16F62X and 62XA
    [supported_devices.ods]
2008-03-31 implemented everything for PIC16F87XA updated supported_devices.ods
    [supported_devices.ods]
2008-04-01 implemented code for 12F629 / 675, 16F630 / 676
    [supported_devices.ods]
2008-04-02 PIC12F629 now partly working PIC16F628 working, only erase works funny...
    [supported_devices.ods]
2008-04-07 implemented all device id's and eeprom sizes of currently implemented PIC's
2008-04-18 improved a lot of things in the programmer (bugfixes)
    [hardware.cpp, hardware.h]
2008-05-06 fixed error in the command line string added exit(0) when a command line is given, to terminate the app when finished
    [main.cpp, main.h]
2008-05-07 fixed makefile and shell script for svn_revision
    [uppmainwindow.cpp]
2008-05-14 inserted SetFocus (would this help for the mac?)
2008-05-14 re-inserted resize(0) in readHexFile (crashed on mac)
2008-05-14 Several fixes for mac and GUI polishing
    [main.cpp, uppmainwindow.cpp, uppmainwindow.h]
2008-05-15 Added drag-and-drop and doubleclick of hex files in Mac OS X, improved wxWidgets 2.9 compatibility and fixed some minor bugs
    [main.cpp, main.h, uppmainwindow.cpp, uppmainwindow.h]
2008-05-16 fixed stack smashing bug
    [hardware.cpp, hardware.h]
2008-05-17 USB Fix (claim interface)
    [hardware.cpp]
2008-05-18 Major bugfixes and first implementation of Bootloader
    [hardware.cpp, hardware.h, main.cpp, uppmainwindow.cpp, uppmainwindow.h]
2008-05-19 Several interface and hardware fixes
    [hardware.cpp, hardware.h, uppmainwindow.cpp]
2008-05-19 added missing returns for some functions
    [hardware.cpp]
2008-05-27 bugfix in order of code memory bytes while programming (bytes in one word were in reverse order in uc_code) removed config words from verify added help2man because the one provided by the open source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
    [hardware.cpp, main.cpp]
2008-06-28 bugfix - changed char* to unsigned char*, if the msb was 1, the next byte would be 0xFF
    [prog.h, upp.c]
2008-07-17 fixed order of bytes for read_code of pic16 devices
    [upp.c]
2008-07-19 added an extra "1" to make the difference between 18F and 16F devices (in devId)
2008-07-19 Font + mac fix
    [preferences.cpp]
2008-07-19 fixed some PIC16 things, config for pic16 not working yet...
    [hardware.cpp, pictype.cpp, prog.h, prog_lolvl.c]
2008-07-21 fixed addresses in hex file for 16F devices
    [hardware.cpp, pictype.cpp]
2008-07-22 updated supported devices for P16F62XA
    [supported_devices.ods]
2008-08-01 added support for PIC12F6XX / 16F6XX devices and it all works except writing data
    [supported_devices.ods]
2008-08-04 added more feedback if something goes wrong in hardware
    [hardware.cpp, main.cpp]
2008-08-13 added libusb windows driver for bootloader and usbpicprog
2008-08-14 added a through hole version of the PCB
    [$savepcb.brd, usbpicprog_th.brd, usbpicprog_th.sch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]
2008-08-15 updated TH pcb
    [usbpicprog_th.brd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]
2008-08-15 regenerated gerbers
    [usbpicprog_th.drl]
2008-08-17 updated location of implemented devices and supported_devices.ods
    [supported_devices.ods]
2008-09-29 added the tags according to file releases
    [$savepcb.brd, bom.xls, supported_devices.ods, usbpicprog.brd, usbpicprog.sch, usbpicprog_0.1.brd, usbpicprog_th.brd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]
2008-10-01 possible to erase 16F876A (but other functions still unsupported)
    [supported_devices.ods]
2008-10-07 fixed many things for the P16F87XA devices (code etc. is now writable, config and data not yet)
    [hardware.cpp, prog_lolvl.c, upp.c]
2008-10-08 sorry, made a mistake in hardware.cpp in autodetect...
    [hardware.cpp]
2008-10-08 fixed write_config for 16F87XA
    [pictype.cpp]
2008-10-14 fixed power VDD / VPP order for 16F87XA (now possible to program it without external power supply)
    [supported_devices.ods]
2008-10-14 started P16F84A
    [supported_devices.ods]
2008-10-15 implemented P16F84A and verify during programming for some devices. (nothing tested yet, I'll get the samples later)
2008-10-17 created zif-socket pcb
    [zif_socket.brd, zif_socket.sch]
2008-10-18 fixed autodetect for some PIC16 devices
    [hardware.cpp]
2008-10-18 routed zif_socket board
    [zif_socket.brd]
2008-10-18 small fix
    [zif_socket.brd]
2008-10-28 general bugfixes and added PIC18F818 / 819w to upp_wx (not yet to firmware)
    [hardware.cpp, pictype.cpp, pictype.h, prog.h, upp.c]
2008-10-30 zif socket for if your PCB doesn't have any ISP header
    [bom.xls, zif_socket.brd]
2008-10-30 modified schematic for PIC24 and dsPIC33 devices, PCB not yet finished, will be released as v0.3
    [usbpicprog.brd, usbpicprog.sch, usbpicprog_th.brd, usbpicprog_th.sch]
2008-10-30 implemented and fixed 16F818 / 16F819 deleted supported_devecies.ods since it is now on the website
    [supported_devices.ods]
2008-10-30 implemented 10F devices, not yet working...
2008-11-17 new devices to implement
2008-11-18 applied configmask for all 18F devices (still need to do it for 16F)
2008-11-18 also implemented the mask for 16F devices
2008-11-21 replaced http://usbpicprog.sf.net with http://usbpicprog.org
    [uppmainwindow.cpp]
2008-11-24 branched the trunk version into upp_wx_thread
    [bom.xls, usbpicprog.brd, usbpicprog.sch, usbpicprog_0.1.brd, usbpicprog_th.brd, usbpicprog_th.sch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]
2008-11-24 make wxFormBuilder generate *_base.* files; don't edit the files it generates; renamed UppMainWindowCallback to just UppMainWindow (callback is a misleading name), which now derives from UppMainWindo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
    [hardware.cpp, main.cpp, main.h, uppmainwindow.cpp, uppmainwindow.h, uppmainwindow_base.cpp, uppmainwindow_base.h]
2008-11-24 restored config,data grids; fixed a couple of GUI details
    [uppmainwindow.cpp, uppmainwindow_base.cpp, uppmainwindow_base.h]
2008-11-26 fix the grid copy routine (is broken also in v.1.1)
    [uppmainwindow_base.cpp]
2008-11-26 display Unknown PIC when there's no PIC connected; give better error in that case when trying to program
    [hardware.cpp, hardware.h, main.cpp, pictype.cpp, pictype.h, uppmainwindow.cpp, uppmainwindow.h]
2008-11-28 restore all keyboard shortcuts in the menus; use default label and default accelerator for stock IDs; this provides a better integration with the native system
    [uppmainwindow.cpp, uppmainwindow_base.cpp, uppmainwindow_base.h]
2008-11-29 revert previous commit (it should have been done in the upp_wx_thread branch)
    [hardware.cpp]
2008-11-29 build fixes for wxMSW
    [hardware.cpp]
2008-11-29 use wxLogError instead of wxMessageDialog: it's shorter to call and provides better support for multiple error messages in sequence
    [uppmainwindow.cpp]
2008-11-29 show the name of the opened HEX file in the title bar; fix UppHexViewGrid to put modified bytes in the right section of the HexFile
    [hardware.cpp, hexfile.cpp, hexfile.h, main.cpp, uppmainwindow.cpp, uppmainwindow.h, uppmainwindow_base.cpp]
2008-11-29 maintain the internal state coherent calling Update* functions when required; call ShoudContinueIfUnsaved when current contents are about to be overwritten
2008-11-29 implement a Reset() function and call it instead of upp_new() when the grid contents need reset and ShoudContinueIfUnsaved has been already called
    [hardware.cpp, uppmainwindow.cpp, uppmainwindow.h]
2008-11-30 make the PROGRAM operation non-blocking by executing it in a secondary thread context; use wxProgressDialog in the meanwhile to show progress and elapsed/remaining time to the user
2008-12-02 implement faster decimal=>hex conversion, since the for() loop is takes many CPU cycles currently
2008-12-02 fix typo ShoudContinueIfUnsaved => ShouldContinueIfUnsaved
    [uppmainwindow.cpp]
2008-12-02 complete thread implementation by moving in secondary thread context also the READ,ERASE,VERIFY operations; introduce the LogFromThread function for safe logging; update the message shown in the wxPr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
2008-12-02 after many tries, fix the hardware.cpp errors including usb.h _after_ the inclusion of wxWidgets headers
    [hardware.cpp, hardware.h]
2008-12-02 fix error given by VisualStudio about joining 'extended strings'
    [uppmainwindow.cpp]
2008-12-03 add to the Actions menu the Connect and Disconnect menu items; the connect menu handler now automatically tries first to connect to the UPP programmer; if it fails, it automatically fallbacks to conn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
    [formbuilder_includes.h, uppmainwindow.cpp, uppmainwindow.h]
2008-12-03 FIX for current libusb warning emitted by ~Hardware about 'USB error: could not release intf nnnnn': use in usb_release_interface the same interface number passed to usb_claim_interface as documented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
    [hardware.cpp]
2008-12-03 intercept invalid auto-detections before m_pPICChoice is modified and Reset() is called
    [uppmainwindow.cpp]
2008-12-03 implement more error-checking in autoDetectDevice(); if the bootloader is connected don't return P18F2550 but rather -1 to signal UppMainWindow that no PICs have been auto-detected
    [hardware.cpp]
2008-12-04 small changes: add developers to the about dialog; give the device ID when autodetecting...
2008-12-05 updated language files, and inserted Spanish, thanks to Mike Kalinowski
2008-12-05 fix typos in some log messages
    [uppmainwindow.cpp]
2008-12-05 remove traces of upp_update_hardware_type
2008-12-05 fixed the bug with autodetect: upp_wx happily says: "Detected: P18F2550"
    [hardware.cpp, pictype.cpp, uppmainwindow.cpp]
2008-12-05 implement the blankcheck inside the thread, too; implement better logging from the thread storing not only the log messages but also their level and time
2008-12-06 fix a bug: move the post-processing code of thread operations in ::OnThreadCompleted
    [hardware.cpp, uppmainwindow.cpp]
2008-12-07 fix for wx28 compilation
    [uppmainwindow.cpp]
2008-12-08 fix background for wxMSW
    [uppmainwindow.cpp]
2008-12-08 fix toolbar bitmaps under wxMSW
    [uppmainwindow.cpp]
2008-12-12 replaced wxEmptyString with "&New" because they were not being translated automatically.
    [uppmainwindow_base.cpp]
2008-12-15 added option to avoid annoying popups in the preferences dialog
    [preferences.cpp, preferences.h, uppmainwindow.cpp]
2008-12-23 fixed error on showing dialogs
    [uppmainwindow.cpp]
2008-12-24 fixed P12F629 / 675
    [pictype.cpp]
2008-12-25 fixed file parameter (command line)
    [hardware.cpp, main.cpp, uppmainwindow.cpp]
2008-12-29 fixed segmentation fault when using the bootloader, also fixed programming data memory with bootloader
    [hardware.cpp, uppmainwindow.cpp]
2008-12-29 some mistakes, cunfused configuration and data area in strings...
    [uppmainwindow.cpp]
2008-12-31 added french translation, thanks to Patrick Nies!, also thanks to Patrick, fixed 40MHz -> 48MHz in io_cfg.h
    [hardware.cpp, io_cfg.h]
2009-01-12 fixed a bug in the data part of read_hexfile, thanks to Patrick Nies
    [hexfile.cpp]
2009-01-24 Mac language files fix
    [main.cpp]
2009-02-04 use wxThreadEvent when building against wxTRUNK; this makes sure that the 'completed' event always gets processed after the 'update' event, even if the thread completes almost immediately (i.e. this 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
    [hardware.cpp, hardware.h, uppmainwindow.cpp, uppmainwindow.h]
2009-02-07 fixed devid for 16F688. Thank you Stefan Cioc
    [pictype.cpp]
2009-02-08 fixed bug in PIC12F6XX, vpp high before vdd
    [prog_lolvl.c, prog_lolvl.h]
2009-02-13 added a second timer for faster (2kHz) voltage pump operation
2009-02-15 use global wxConfig object, don't create/store our own instance in UppMainWindow; add persistency support for the main frame (under wx2.9)
2009-02-17 inserted Patrick Nies his proposed changes, thank you Patrick!
2009-02-24 fix assertion failure: UppMainWindow::OnThreadUpdate is executed in the main thread context and thus LogFromThread cannot be used
    [uppmainwindow.cpp]
2009-02-25 fix compilation with MSVC on Windows: 1) do not use non-constant expressions when declaring a static buffer; rather use a BLOCKSIZE_MAXSIZE constant 2) add a simple resource file to make the final EX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
    [hardware.cpp, hardware.h]
2009-03-02 added some debug information for "unknown error during verify"
    [hardware.cpp]
2009-03-12 branched upp_wx: upp_wx_xml uses Piklab's XML files to load data about the PICs; this allows for easier PIC info management and for better GUI (more details about each PIC). Additional XML info are c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
2009-03-13 compile fixes for GCC (4.3.3); fix PIC datasheet URL to properly use 'as_sitesearch'
    [uppmainwindow.cpp]
2009-03-14 fix wxGTK behaviour of the PIC info page introducing UppPackageViewWindow: a simple canvas for the drawing of the package
    [uppmainwindow.cpp, uppmainwindow_base.cpp, uppmainwindow_base.h]
2009-03-17 a couple of typo fix
2009-03-18 remove old code for loading the packages from bitmap: drawing them is much more flexible; fix lots of warnings about deprecated CRT functions in MSVC2008 always including wx/defs.h header before std 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
    [configview.cpp, hardware.cpp, hexfile.cpp, main.cpp, pictype.cpp, preferences.cpp, preferences.h, uppmainwindow.cpp]
2009-03-18 fix loading of Piklab XML files when UsbPicProg is installed on Windows; load the min/max frequencies and the programming/working voltages of the PICs
    [pictype.cpp, pictype.h, uppmainwindow.cpp, uppmainwindow_base.cpp]
2009-03-20 use the new ToCDouble() function to ensure parsing is correct also for locales which use as decimal point not a dot (requires latest wx TRUNK)
    [pictype.cpp]
2009-03-22 fixed some small things... still looking for a bug which gives the error "Unable to load XML data for PIC ..."
    [configview.cpp, pictype.cpp, pictype.h]
2009-03-23 fixed segfault when combo changed
    [pictype.h, uppmainwindow.cpp]
2009-03-23 fixed load of vdd_prog_write
    [pictype.cpp]
2009-03-24 fixed load of config into choice components
    [configview.cpp, pictype.cpp, uppmainwindow.cpp]
2009-03-28 fixed generation of configword
    [configview.cpp]
2009-03-30 fixed config word generation for 16 bit devices
    [configview.cpp, pictype.h]
2009-03-30 fixed eeprom size (+1) and also used m_pic->is16Bit() in stead of Name.find("P18F")==0 in hardware
    [hardware.cpp, pictype.cpp, uppmainwindow.cpp]
2009-04-02 do not expand the misc info panel when resizing; it doesn't make much sense
    [uppmainwindow_base.cpp, uppmainwindow_base.h]
2009-04-02 cleanup some code commented out; add more doxygen comments; make the preference dialog use wxDefaultSize instead of fixed values (fixed values are not translation-friendly)
    [configview.cpp, hardware.cpp, hexfile.cpp, main.cpp, pictype.cpp, pictype.h, preferences.cpp, uppmainwindow.cpp]
2009-04-03 draw the pin numbers inside the pin rects for packages with pins on all 4 sides; in this way the pin numbers of different sides don't overlap. some nomenclature cleanup inside DrawPins()
2009-04-11 no real change; just ensure all sources/headers have correct newline types and svn:eol-style is native
    [configview.cpp, pictype.cpp, preferences.cpp, preferences.h]
2009-04-11 fix relayouting of the info panel on wxMSW
    [uppmainwindow.cpp]
2009-04-11 Correct the style of doxygen comments so that it's uniform in all headers. Add more doxygen docs to the Hardware class and more (non-doxygen) comments inside Hardware class's private functions. Avoid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
    [hardware.cpp, hardware.h, main.h]
2009-04-13 minor code style cleanup; more pleasing prefix for log-generated thread messages (and show the prefix only in the progress dialog, not in the log window shown at the end)
2009-04-15 fixed windows installer and wxDevcpp project
    [configview.cpp]
2009-04-18 added extra functionality to the pcb; 5V on VPP and voltage dividers on PGD and PGC
    [usbpicprog.brd, usbpicprog.sch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]
2009-04-21 fixed faulty conversion from string to wxString
    [pictype.cpp, pictype.h]
2009-04-21 same as last message: wxString and string inconsistency (won't compile on mac)
    [uppmainwindow.cpp]
2009-05-01 add zoom in/out/fit to the PIC info panel for zooming the package view window; fix package drawing just after startup under wxGTK; change package drawing code to not impose arbitrary limitations on t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
    [pictype.cpp, uppmainwindow.cpp, uppmainwindow.h, uppmainwindow_base.cpp, uppmainwindow_base.h]
2009-05-01 add bitmaps for zoom buttons on platforms != wxGTK
2009-05-01 rename Pic::Config field in Pic::ConfigWords for more clarity; add more docs about Pic class fields; add more comments and some TODOs in new parts of code which manipulate the configuration flags; do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
    [configview.cpp, pictype.cpp, pictype.h]
2009-05-02 do not crash when zooming in/out too much
    [pictype.cpp]
2009-05-02 a little more docs; don't use an array of fixed size for filename
    [hexfile.cpp, hexfile.h]
2009-05-03 fix a couple of doxygen warnings
2009-05-03 fix many TODOs using ConfigWord::GetMask() where needed instead of recalculating the mask every time with custom code; move Pic::ConfigMask member into HexFile::m_configMask; add HexFile::verifyXXX f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
    [configview.cpp, hardware.cpp, hardware.h, hexfile.cpp, hexfile.h, pictype.cpp, pictype.h]
2009-05-03 fix HexFile return value comparison after previous revision
    [uppmainwindow.cpp]
2009-05-03 fix return value comparison for HexFile methods
    [main.cpp]
2009-05-03 use wxLog facilities instead of cerr/cout; make code more readable; add more checks against m_handle being NULL; add more comments to explain what's going on; fix some memory leaks (not revised the r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
    [hardware.cpp]
2009-05-03 fix verify operations by calling HexFile::calcConfigMask in HexFile::putConfigMemory
    [configview.cpp, hardware.cpp, hexfile.cpp, hexfile.h]
2009-05-03 fix memory leaks by allocating HexFiles on the stack instead of using the heap
    [hardware.cpp]
2009-05-03 make correct use of "unsigned char" for Hardware functions: this fixes some long-standing MSVC warnings about assigning to char vars CMD_XXX values which are greater than 0x70
    [hardware.cpp, hardware.h, uppmainwindow.cpp]
2009-05-03 fix for invalid element access: make sure that m_configMask is big enough
    [hexfile.cpp]
2009-05-03 treat m_hardware==NULL as disconnected hardware: provide the user a message error instead of exiting silently
    [uppmainwindow.cpp]
2009-05-03 fix an error introduced during refactoring: use memory.size() instead of memorySize
    [hardware.cpp]
2009-05-09 more info for the assert message in HexFile::calcConfigMask (which needs to be fixed somehow)
    [hexfile.cpp]
2009-05-10 fix the progress dialog auto-hiding after completion of the first sub-operation of the various upp_thread_* functions
    [uppmainwindow.cpp]
2009-05-10 adopt the same convention used for bulkErase(): return value 1 means "OK"; negative values mean something was wrong
    [hardware.cpp, hardware.h, uppmainwindow.cpp]
2009-05-10 fix error description reported for verify errors: the read/expected fields were flipped after last commits
    [hardware.cpp, hexfile.cpp]
2009-05-20 some last value changes in the pcb (0.3) almost ready to release!
    [usbpicprog.brd, usbpicprog.sch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]
2009-05-24 added voltage check on VPP
    [usbpicprog.brd, usbpicprog.sch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]
2009-05-25 some code cleanup, hopefully better verify during programming for some 16F devices
2009-05-27 fixed name of control file for amd64
    [hardware.cpp]
2009-05-29 fixed some address things for dsPIC
    [configview.cpp, hardware.cpp, hexfile.cpp, pictype.h, uppmainwindow.cpp]
2009-05-29 fixed faulty reads / writes after one try
    [hardware.cpp]
2009-06-01 fix a couple of typos in UppMainWindow::checkFirmwareVersion
    [uppmainwindow.cpp]
2009-06-01 add pin names for PIC18F2550
2009-06-10 fixed configview to display all (2 or 4) digits from the config word fixed verify to read only the data which is in the hex file (faster)
    [configview.cpp, hardware.cpp, hardware.h]
2009-06-11 didn't change much, just some delay values, dsPIC still not giving any sign of life...
    [prog_lolvl.c, upp.c]
2009-06-14 Made it compile and work on OS X again. Only some user interface issues, and i'm not sure if the po files work, but it is useable.
    [main.cpp, pictype.cpp, pictype.h]
2009-06-16 code cleanup, stop verify immediately after first error
    [configview.cpp, hardware.cpp, hardware.h, hexfile.cpp, hexfile.h, main.cpp]
2009-06-18 fixed config address for configuration memory
    [hardware.cpp]
2009-06-18 fixed configaddress also for read...
    [hardware.cpp]
2009-06-19 skipped double read of data for PIC16 devices when read from address 0
2009-06-20 fixed accidental erases and other unwanted behaviour on autodetect for some 16F and 12F devices
    [hardware.cpp]
2009-06-26 fixed BIG error in PCB v0.3 / implemented initialization of newly used pins in firmware
    [usbpicprog.brd, usbpicprog.sch]
2009-06-26 I screwed up.... :( fixed diode !
    [usbpicprog.brd, usbpicprog.sch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]
2009-06-29 implemented 12F61X devices
2009-06-29 fixed new pic family 12F61X
    [pictype.cpp]
2009-06-30 copied usbpicprog.sch to usbpicprog_th.sch and translated to .brd file - still needs to be routed!
    [usbpicprog_th.brd, usbpicprog_th.sch]
2009-06-30 routed some more tracks
    [usbpicprog_th.brd]
2009-07-21 finished usbpicprog through hole version
    [usbpicprog.brd, usbpicprog_th.brd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]
2009-07-24 released pcb 0.3
    [bom.xls, usbpicprog.brd, usbpicprog.sch, usbpicprog_th.brd, usbpicprog_th.sch, zif_socket.brd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]
2009-07-24 fixed retry after verify error for some 16F devices
    [prog_lolvl.c]
2009-07-29 fixed set_pictype for 12F61X and 16F716
    [upp.c]
2009-07-31 implemented PIC16F785, fixed xml data for 12F683 18F2458, 18F2553, 18F4458, 18F4553
    [pictype.cpp]
2009-08-14 vpp procedure for PIC30 (still not working)
    [hardware.cpp, pictype.cpp, prog_lolvl.c]
2009-08-21 fixed segfault for saving hexfile (dsPIC)
    [hexfile.cpp]
2009-08-26 fixed load / open hexfile for dsPIC, implemented debugging command in firmware (to debug dsPIC)
    [hexfile.cpp, prog_lolvl.c, upp.c, upp.h]
2009-08-31 fixed the debugging command for dsPIC
    [hardware.cpp, hardware.h, main.cpp, main.h, upp.c]
2009-09-13 fix assert failure in CRT under Windows when m_filename is an empty string
    [hexfile.h]
2009-09-13 no real change; just fix some warnings from MSVC when compiling under windows
    [hexfile.cpp]
2009-09-16 updated bill of materials
    [bom.xls]
2009-09-25 finally got response from a dsPIC device!!!
2009-10-12 rewritten the backup and restore of bandgap and osccal registers for 12F629 and similar devices. It does now go through the PC application as well
2009-10-13 added the windows driver to the installer
2009-10-19 fixed silkscreen error on th-pcb (labels of D8 and D9 swapped) fixed error on zif_socket PCB, PGD and PGC for dsPIC 40 pin connected to wrong pins
    [usbpicprog_th.brd, zif_socket.brd, zif_socket.sch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]
2009-10-19 changes also apply to PCB-0.3 in tags
    [usbpicprog_th.brd, zif_socket.brd, zif_socket.sch]
2009-11-05 fixed a bug where the second configuration word of some 16F devices (16F87/88, 7X7, 88X) were ignored
2009-11-10 fixed bug in opening / saving hex data for EEPROM memory for 10F, 12F and 16F devices. The bug caused only half of the EEPROM data to be loaded
    [hexfile.cpp]
2009-11-18 added "Restore BandGap and OscCal" function for PIC12F629 and similar devices
2009-11-18 removed windows driver from the root of the installer (don't know why it was there)
2009-11-25 changed ADC settings for better AD aquisition
2009-11-27 fix the 'Connected' string appearing twice on the log dialog: Append() is not a const function and does modify the firmwareVersion.versionString variable; we need to copy that string before appending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
    [hardware.cpp, hardware.h, uppmainwindow.cpp]
2009-11-28 fix MSVC++ warning about signed/unsigned making numberOfBytes an unsigned var
    [hardware.cpp, hardware.h]
2009-12-02 added "reset target" before autodetection of PIC16 devices, because the first autodetection sometimes went wrong for 12F629 which caused them to be erased on PIC18 autodetection
    [upp.c]
2009-12-18 bugfix - reading didn't work anymore after change of frm when NumberOfBytes was specified as 0, now numberOfBytes is always specified and cannot be left blank anymore
    [hardware.h, main.cpp, uppmainwindow.cpp]
2009-12-21 fixed all compile warnings
    [configview.cpp, hardware.cpp, hexfile.cpp, pictype.cpp, pictype.h, uppmainwindow.cpp]
2010-01-01 first step towards I2C Eeprom implementation
2010-01-02 added smaller I2C eeproms than 24C512
2010-01-05 another step towards I2C eeprom
2010-01-06 Fixed some problems with PIC_Select, I2C_Eeprom now working partly
    [hardware.cpp, prog_lolvl.c, prog_lolvl.h, uppmainwindow.cpp]
2010-01-30 fix MSVC warning: not all control paths have a return statement
    [hardware.cpp, pictype.h]
2010-01-30 correctly propagate eventual errors in writeBlock() and readBlock() back to the original callers
    [hardware.cpp, hardware.h]
2010-01-31 replace libusb-0.1 windows driver with libusb-1.0 driver for both 32 and 64bit Windows systems.
2010-02-01 catch potential memory leaks by including wx/msw/msvcrt.h which when using MSVC allows to see all leak sources at program exit.
    [configview.cpp, hexfile.cpp, pictype.cpp, preferences.cpp, uppmainwindow.cpp]
2010-02-06 fix Italian translation; update also other translation files; fix some mispelled words in the sources; always name the USB bus when using wxLogError() from hardware.c
    [hardware.cpp, pictype.cpp, uppmainwindow.cpp]
2010-02-07 add the .INF for the bootloader (which has a different PID); add copyright to the INF files; give a more descriptive name to the .INF file for the programmer
2010-02-07 fix USB transfers by hardcoding the endpoint types instead of asking them to the hw before each transfer (this behaviour was introduced by error during the libusb0.1 => 1.0 porting)
    [hardware.cpp, hardware.h]
2010-02-11 move all windows-related stuff into the "win" folder (driver, deps, installer) and the "build\win" folder (the wxDevCpp project)
2010-02-11 add the DPinst utility XML configuration file and the DPinst redistributable to be used for driver installation.
2010-02-13 Fix and test the NSIS installer for 64bit platforms: - package only the right files for the architecture of the installer - dpinst.exe is architecture-dependent; move it in the appropriate folder and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
    [main.cpp, uppmainwindow.cpp]
2010-02-14 make sure that the binary files under win/deps are of the correct type: release builds with /MD switch; add a win/deps/info.txt file describing some details about those binary files.
2010-02-19 implemented PIC12F508, 509. (Firmware still has to be completed)
    [usbpicprog.drl]
2010-02-20 another attempt to fixing driver installation: <quietInstall> tag is probably forcing installation failure because with quiet mode ON Windows cannot display a warning about the driver being unsigned;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
2010-02-21 fixed some errors in the zof_socket schematic for PIC10F, the PCB still needs to be re-routed
    [zif_socket.brd, zif_socket.sch]
2010-02-21 updated zif_socket
    [zif_socket-Component.gtl, zif_socket-Copper.gbl, zif_socket-Mask_Back.gbs, zif_socket-Mask_Front.gts, zif_socket-PCB_Edges.gbr, zif_socket-SilkS_Back.gbo, zif_socket-SilkS_Front.gto, zif_socket-SoldP_Back.gbp]
2010-02-22 print even more details in the details window!
2010-02-26 fixed build for osx
    [hardware.cpp, main.cpp, pictype.cpp]
2010-03-01 fixed problem with adding of data to every datablock when compiling on msvc. (union BootloaderPackage was handled different by msvc than by gcc)
    [hardware.cpp, hardware.h]
2010-03-01 fix miscalculations of the main frame best size by calling SetSizerAndFit() only when the creation of all subwindows (in this case the toolbar) has been performed. This requires manual edits to the w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
    [uppmainwindow.cpp, uppmainwindow_base.cpp]
2010-03-01 include a small trick to avoid forgetting about the hand modifications in the future (in case the uppmainwindow_base.cpp file is regenerated through wxFormBuilder)
    [uppmainwindow.cpp, uppmainwindow_base.cpp]
2010-03-02 fix for building against wx2.9.0
    [uppmainwindow_base.cpp]
2010-03-05 update to the latest wxWidgets presets which allow for a simpler upp bakefile and which remove the TARGET_CPU option from formats which do not support it (currently watcom, borland, mingw).
2010-03-05 fix compilation under MSVC: - do not leave uninitialized vars in Hardware ctor (this would lead to a crash later) - reuse disconnect() code in Hardware dtor - fix return value and return statements i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
    [hardware.cpp, hardware.h]
2010-03-07 reorganize application flow by placing the 'main' code in OnRun() instead of OnInit(); do not call exit() from CmdLineMain(): it makes impossible to de-allocate memory allocated by OnInit() since OnE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
    [hardware.cpp, hardware.h, main.cpp, main.h]
2010-03-07 clean up IOTest: - rename it to IOTestDialog for coherency with other classes - add some more description to the existing static texts and add a description of the io test feature at the top of the d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
    [formbuilder_includes.h, uppmainwindow.cpp, uppmainwindow.h]
2010-03-08 call disconnect() after every USB read / write error, to avoid unlimited loops of error messages
    [hardware.cpp, hardware.h]
2010-03-10 changed some resistor values in the schematic for better VPP behaviour, also updated the ZIF socket for I2C Eeprom
    [usbpicprog-Component.gtl, usbpicprog-Copper.gbl, usbpicprog-Mask_Back.gbs, usbpicprog-Mask_Front.gts, usbpicprog-PCB_Edges.gbr, usbpicprog-SilkS_Back.gbo, usbpicprog-SilkS_Front.gto, usbpicprog-SoldP_Back.gbp]
2010-03-10 added two resistors for the I2C data / clock lines to be pulled up
    [zif_socket-Component.gtl, zif_socket-Copper.gbl, zif_socket-Mask_Back.gbs, zif_socket-Mask_Front.gts, zif_socket-PCB_Edges.gbr, zif_socket-SilkS_Back.gbo, zif_socket-SilkS_Front.gto, zif_socket-SoldP_Back.gbp]
2010-03-10 released pcb 0.3.1 (just some minor changes in resistor values)
    [bom.xls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]
2010-03-10 removed some unnecessary files from the pcb folder
    [usbpicprog_0.1.brd]
2010-03-15 I am sorry, I messed up uppPackage since r834. The addresses were totally messed up, so any programming would fail... Fixed it now by exchanging AddrU and AddrL (wrong order)
    [hardware.h]
2010-03-23 changed UppConfigViewBook to wxLB_LEFT in stead of DEFAULT because it didn t appear well on osx
    [configview.cpp]
2010-04-11 add a small example which blinks a LED on a 18F4553 (tested and working with UPP and current UPP_WX version)
2010-04-14 added dice and 12F 16F blink to the examples
    [dice.brd, dice.obj, dice.sch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]
2010-04-16 updated portuguese translation. Many thanks to Vinícius Pais de Oliveira
2010-04-20 added examples to Makefile.am
    [dice.brd, dice.obj, dice.sch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]
2010-05-04 added support for Bosnian translation (was missing in wxWidgets)
    [main.cpp]
2010-05-12 fixed timeout on reconnect bootloader in Windows
    [hardware.cpp, main.cpp]
2010-05-21 released 0.4.0
    [dice.brd, dice.obj, dice.sch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]
2010-06-21 cleaned up code for 10F devices
2010-07-21 implemented PIC18F24J10, 25J10, 44J10 and 45J10 devices. Also fixed a config select update bug
    [configview.cpp, hardware.cpp, prog.h, prog_lolvl.c, upp.c]
2010-08-06 fixed issue with wxFormatString ni configview.cpp when compiling against wxWidgets 2.9.1
    [configview.cpp]
2010-09-02 fixed autodetect for 18J (returning 16F value instead)
    [hardware.cpp]
2010-09-02 added run and stop button to the gui in order to run the target device
2010-09-13 tagged 0.4.1-beta for firmware and software
    [dice.brd, dice.obj, dice.sch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]
2010-09-22 some tries towards 18J devices, still no success
2010-09-23 added all 18F2XJXX and 18F4XJXX devices to xml files and added Patrick Nies to credits for his excellent work for low voltage devices!
2010-09-23 fixed (and now working) 18F2XJXX devices! Many thanks to Patrick Nies!
    [prog_lolvl.c]
2010-10-15 fixed 10F200, 10F202, 10F204, 10F206
    [main.cpp, uppmainwindow.cpp]
2010-10-15 fixed 10F20X /12F508 calibration register restore
    [hexfile.cpp, main.cpp, main.h]
2010-10-25 Fixed erase sequence for 16F62X, as well as program entry mode (VPP first)
    [prog_lolvl.c]
2010-11-14 Updated pinout for some 16F devices, thanks to MorgMcz!
2010-11-15 released 0.4.1 of upp_wx
    [dice.brd, dice.obj, dice.sch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]
2010-11-19 fixed two open bugs for osx
    [uppmainwindow.cpp]
2010-11-22 for PIC18FXXJXX devices, moved VPP_RST=0 (release from reset) to line 84 in order to have the VPP line not floating during the MCHP command. Thanks to Bill O'Shaughnessy
    [prog_lolvl.c]
2010-12-14 added XML files for 24FXXKAXXX devices
2010-12-20 changed autodetection, added extra cycle for 16F devices (one for VPP first, one for VDD first)
2011-01-07 removed verify during programming for 1word-at-a-time PIC16 devices since it is causing problems
    [upp.c]
2011-01-07 Verify code and data memory now done before writing config memory in order to be able to verify code protected devices
2011-01-17 re-enabled verify during programming for 1-word-at-a-time 16F devices. Hope it works now, else I will remove it again Also added the 12F617, thanks to BorgM!
2011-01-22 fixed erase cycle for 16F62X devices. It now works sometimes, not always... Try erasing, then blankcheck a couple of times and see if it erases. Then program without setting "erase before programming"
2011-01-26 released 0.4.2-beta
    [dice.brd, dice.obj, dice.sch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]
2011-02-28 changed some values in the PCB
    [usbpicprog-Component.gtl, usbpicprog-Copper.gbl, usbpicprog-Mask_Back.gbs, usbpicprog-Mask_Front.gts, usbpicprog-PCB_Edges.gbr, usbpicprog-SilkS_Back.gbo, usbpicprog-SilkS_Front.gto, usbpicprog-SoldP_Back.gbp]
2011-03-01 removed old SVN things like tags / branches
    [$savepcb.brd, bom.xls, dice.brd, dice.obj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]
2011-03-09 removed some mac-specific fixes to try with latest wxWidgets-svn
    [uppmainwindow.cpp]
2011-04-12 Added an option to skip localization
    [main.cpp, preferences.cpp, preferences.h, preferences_base.cpp, preferences_base.h, uppmainwindow.cpp]
2011-04-12 exchanged public UppMainWindowBase, public wxThreadHelper to avoid assertion fail at close
    [uppmainwindow.h]
2011-05-18 fixed config Address in some 10F, 12F5xx and 15F5xx devices
    [hexfile.cpp, pictype.cpp, pictype.h, preferences.cpp, preferences.h, preferences_base.cpp, preferences_base.h]
2011-06-15 moved initialization of the help file to the actual help event, because it causes a crash with wxWidgets and compiz
    [uppmainwindow.cpp]
2011-07-24 Increased Erase delay for 16F62X devices
2011-08-01 Added upp_wx support for 18F872X family devices
2011-11-26 implemented 3.3V dsPIC30F devices
2011-11-26 fixed erase delay in pic18FxxJxx devices
2011-12-31 fixed DelayMs to always take longer than cnt
    [interrupt.c]
2012-01-20 fixed DelayMs for overflows of tick
    [interrupt.c]
2012-01-21 disabled global interrupts on interrupt function entry
2012-01-23 Fixed timing bug with DelayMs and while( (tick-ticksave)<cnt ) ; An interrupt could occur in the middle of calculating tick-ticksave causing the time to end prematurely. replaced all remaining ticksa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
    [interrupt.c, interrupt.h, prog_lolvl.c, upp.c]
2012-01-23 Missed prototype for startTimeMs( unsigned cnt ) changed arg for DelayMs from long to unsigned int
    [interrupt.c, interrupt.h]
2012-01-23 modified most references to hardware to macros
    This is in preparation for creating a test harness that will print out
    hardware actions. This can then be used as a debugging aid as well
    as a means of verifying changes do not inadvertently introduce
    unwanted changes
2012-01-23 Added test harness, compile in Linux. Does 1 device now P18F2XXX
    compile with
    gcc -DTEST -Drom="" -Itest -I. test/test.c prog_lolvl.c prog.c device.c -o runtest
    Main work is in test.c and test.h
2012-01-24 First pass, all programming functions are functions per pictype bulk_erase, read_code... have all been separated into individual functions. There will be a device table indexed by pictype that will h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
2012-01-24 Switched to using table instead of switch to select proper function Added table entry for part voltage (only partially impl)
2012-01-24 Some 3.3V changes
2012-01-24 Exactly duplicates the test output from original code
    NOTE there are several problems/omissions in the original code that
    are present
    Some more work needs to be done on the test harness to get/ensure
    better coverage
    [device.c, pictype.h, prog_lolvl.c, write_code.c, write_data.c, write_data.h]
2012-01-25 Added table driven read_code
    This got missed before
    [pictype.h, read_code.c]
2012-01-25 Update test modified to give more complete coverage
    added types P18F872X,P18FXX31,P18FX220,P16F182X to the
    set family switch. In the original they ended up being P18F2XXX's
2012-01-25 updates to comply with new test program
    All matches with original (really this time!) except 12F508 because
    of bug in original.
    Replicated several small bugs in original to set this baseline
    [pictype.h, write_config_bits.c]
2012-01-25 Corrected read_code for 12F508
    base version didn't set config address correctly. as a result a read
    to address zero only returned the first address, regardless of
    blocksize.
    [pictype.h]
2012-01-25 FIXES: General cleanup of set_vdd_vpp
    P24FXXKAXXX
    added 25ms delay after finish sending key bits
    P24FJXXXGA0XX
    P24FJXXXGA1
    P24H
    added 25ms delay after finish sending key bits
    changed Vpp sequence to toggle Vpp, send key, set Vpp
    P18F6XKXX
    P18F67KXX
    added enablePGD_LOW, enablePGC_LOW
    dsP30F_LV
    base version didn't handle dsP30F_LV (fell through to default)
    fixed to use ds30F version
    [pictype.h, prog_lolvl.c, prog_lolvl.h]
2012-01-25 Modified write_data to check currDevice for 3.3V
    This eliminated write_code_PIC18LV
2012-01-26 FIXES: P18F45J10 P18F97J60,P18F6XJXX,P18LF13K22,P18LF14K22
    enabling PGD_LOW moved from functions to enter_ISCP
    In write_data these devices did not re-enable PGD_LOW
2012-01-26 FIXES: P18LF4XK22 should be a 3.3V part, added
2012-01-26 FIXES: P24FXXKAXX failed to reset 3.3V settings after reads
    PGD/PGC settings moved around in enter_ISCP
    Passed 0 to dspic_read_16_bits, fixed since all reads reset 3.3V
    settings correctly
2012-01-26 Restructured the code around 3.3V parts
    New assumptions
    PGD_LOW/PGC_LOW always 0
    PGD_LOW/PGC_LOW tristate settings are set in enter_ISCP
    modified only by reads, which set pins to inputs for the read and then
    back to outputs. The rest of the code doesn't have to worry about them
    This fixed several devices
    P18F45J10
    P18F97J60
    P18F6XJXX
    P18LF13K22
    P18LF14K22
    these parts did not reset 3.3V correctly after reads in write_code
    P18LF4XK22
    this part was NOT treated as 3.3V
    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
    [bulk_erase.c, bulk_erase.h, io_cfg.h, pictype.h, prog_lolvl.c, prog_lolvl.h, read_code.c, read_data.c]
2012-01-26 This fixes my last FIX (and it was in the middle of the day!)
    Not sure how I screwed up, but...
    Now only minor changes for original and all that was well is well
    again
2012-01-26 fixed up I2c code to compile with C18
    Fixed some accidental changes and updates PGC/D macros so this
    would compile for target (with C18)
    [prog_lolvl.c]
2012-01-26 Added support to allow firmware to enter bootloader
    This will allow the application progam to initiate a switch to the
    bootloader, update the firmware and then reboot into updated
    firmware
    [main.c]
2012-01-27 FIXES: Flagged a few case where && was used instead of &
    [read_code.c, write_code.c]
2012-01-27 increased support for PIC24 devices, changed way device table works
    Collected Pic24 devices in one file pic24.c
    moved the device table entries to their own section so they could be
    added in different files.
    added pictype to the structure so they are not indexed by pictype, so
    they can be in any order
2012-01-28 Added PIC24H and dsP33F devices
2012-01-29 Changed CMD_READ_CODE in uc_ccode and upp_wx to send CONFIG flag
    Added flag BLOCKTYPE_CONFIG flag to system, that is sent when
    the when reading config data.
    Added test for blocksize < 8 to set BLOCKTYPE_CONFIG with
    CMD_READ_CODEold as backward compatability.
    replaced all uses of contants in firmware and replaced with
    Created BLOCKTYPE_FIRST, BLOCKTYPE_LAST, BLOCKTYPE_CONFIG
    [bulk_erase.c, hardware.cpp, hardware.h, pic24.c, pictype.h, prog_lolvl.h, read_code.c, read_code.h]
2012-01-29 Removed the 24FJXXGBXXX devices (for now) - no xml files
2012-01-31 minor changes to FIXME's
    [io_cfg.h, prog_lolvl.c, upp.h]
2012-01-31 Forgot to update CMD_SET_PICTYPE, when changing device table
    When the device table is not in enum order, need to search for pictype
2012-01-31 Dumb,dumb,dumb - terminate macros with while(1) should be while(0)
    At least it reminds me how dumb I can be and how hard it is to find
    obvious bugs no matter how often you read them!
    [io_cfg.h]
2012-02-02 Implemented cmdline options -BOOT and -RST
    -BOOT resets firmare to bootloader mode and reconnects
    -RST resets bootloader
    [hardware.cpp, hardware.h, main.cpp, main.h]
2012-02-02 FIxes for PIC24 parts
    PIC24's use different key
    [pic24.c, prog_lolvl.c]
2012-02-03 Fixed several issues - PIC2404KA200 now works
    Fixed several issues with pic24.c set enter_ISCP to the low voltage
    method for the KA200
    Fixed the enter_ISCP for p24 parts. The enter routine now does the
    initial NOP and GOTO 200.
    added clock_delay() between all PGC changes (not sure if it was
    necessary)
    [pic24.c, prog_lolvl.c]
2012-02-06 Made change to compare with original - not strictly correct
    made code react the same as original could be a problem if the app
    read more that 8 bytes/config words on a PIC16 at one time
    [read_code.c]
2012-02-06 FIxed bug - pic24 devices would not write last incomplete block
    [pic24.c]
2012-02-07 swapped order of autodetection of different 24F devices because one was not autodetected the other way
    [hardware.cpp]
2012-02-09 fixed warnings "function call without prototype"
    [main.c, main.h, pic24.c, upp.c]
2012-02-10 fixed 85J50, now also config registers do write
    [hardware.cpp, pictype.h, write_config_bits.c, write_config_bits.h]
2012-02-13 Added support for 16F1847 and improved support for other 16F18XX devices, thanks to Christian - Equinox
2012-02-21 Fixed code for EEproms NOTE app is wrong for <32Kbit chips
    [prog_lolvl.c, upp.c, write_code.c]
2012-02-22 missed this file in I2C update
    [read_code.c]
2012-02-22 Minor changes
    no reason to set PGD_LOW (always set low now)
    added 2ms delay after sending code for compatibility with PIC24 devices
    pic_read_byte2 sets TRISPGD_LOW=0
2012-02-22 Bugs with 3.3V
    BUG: multiple problems in write_code not reseting TRISPGD_LOW after reads
    BUG: READ_CODE/DATA never set TRISPGC_LOW=0
    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
2012-02-22 BUGS: with 3.3V
    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
2012-02-22 FIxed up various compile time warnings and made test program compile
    [io_cfg.h, main.c, main.h, pic24.c, prog_lolvl.c, read_code.c, write_code.c]
2012-02-23 Fixed minor code issues.
    P18F872X
    wrote code blocks before they were full - no harm if the code blocks
    are written sequentially
    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
    [write_code.c]
2012-02-23 fixed small error in original code
    the pics ignored this extraneous command anyway
    affects
    P12F61X
    P16F716
    P16F785
    P16F87
    [write_config_bits.c]
2012-02-23 P16F18XX deleted extraneous command
    deleted extraneous program command and switched to using
    write_code_P16F84A
2012-02-28 fixed stop programming command for pic16F91X devices
2012-02-29 Forgot to add device_table.h
2012-05-08 fixed some build issues for Windows
    [hardware.cpp, main.cpp, uppmainwindow.cpp]
2012-06-17 fixed write config for 18f14K22
    [device_table.h]
2012-06-17 not reset the application every second when the programmer is not found
    [bulk_erase.c, uppmainwindow.cpp, uppmainwindow.h]
2012-06-17 fixed byte 14 and 15 of every block (was taking 6 and 7 in stead)
    [write_code.c]
2012-06-17 fixed change of pic type to default every two seconds
    [uppmainwindow.cpp]
2012-06-19 added some more 24FJ devices
2012-06-22 restored shortcuts, removed some debug text
    [hardware.cpp, uppmainwindow.cpp, uppmainwindow_base.cpp, uppmainwindow_base.h]
2012-06-27 Added doc for implemented devices
2012-06-28 fixed bulk erase for PIC18FXX23
    [device_table.h]
2012-09-30 fixed write_config_bits for 18FXX31
    [device_table.h]
2012-10-11 Changed page size for lower size I2C eeprom
2012-10-19 Fixed Preferences->Autodetect on startup (setting was not loaded from settings file)
    [uppmainwindow.cpp]
2012-11-05 added preliminary (totally untested!!!) 3d printable case for usbpicprog
    [usbpicprog_case_bottom.stl, usbpicprog_case_top.stl]
2012-11-28 Replaced D4 with 0R resistor
    [usbpicprog.sch]
2013-02-11 fixed Windows 8 (especially driver)
    [uppmainwindow.cpp]
2013-02-21 Changed component value on PCB
    [usbpicprog.sch]
2013-03-07 BUG: fixed read/write data (eeprom)
    [pic24.c]
2013-03-07 BUG: fixed reading more than 64K words of code
    [pic24.c]
2013-03-07 removed "Exit the Reset vector" code (done in enter_iscp) cleaned up compile errors minor formatting
    [pic24.c]
2013-03-07 BUG: fixed reading of xml files with missing config words (i.e.nonexistant) also set config size to even # bytes for 24bit files some have end as last byte, some last+1
    [configview.cpp, pictype.cpp]
2013-03-07 Added support for 24EP devices in uc_code Added xml data for 24EP256MC202 Fixed bug in device.h PICTYPE (enum) is signed so it didn't fit in 7 bits. changed structure to unsigned
    [device.h, hardware.cpp, pic24E.c, pictype.cpp, pictype.h, prog_lolvl.c, prog_lolvl.h]
2013-05-21 minor change to code - make it the same as pic24.c fix compile warning
    [pic24E.c]
2013-05-21 Fixed Bug
    needed a NOP after the load of W6
    simplified by deleting test for first block and always load W7
    [pic24.c]
2013-05-21 Fixed Bug: did not work with older firware revs
    Fixed so that it now works with firmware protocol 1
    [hardware.cpp]
2013-05-29 Ignore non-existing device id for 16C devices
2013-05-29 no return error if xml file contains no device Id, just a cout message
    [pictype.cpp]
2013-08-02 fixed eeprom location for 16F1824, 1826, 1827
    [hexfile.cpp]
2013-08-02 fixed pictype for all 16LF devices
    [pictype.h]
2013-08-03 fixed hex file offset of 16F devices with two config words
2014-01-06 fixed operating voltages of 18f14k22
2014-01-07 Updated PIC18F6XKXX processor voltage (it is 3.3V).
2014-01-07 Updated another device from 5V->3V.
2014-03-09 More stable programming of 16F devices
2014-03-23 fixed stable write for pic16F62X, especially the bulk_erase was not always working. After some thesting replaced with the 16F84A bulk erase sequence
    [device_table.h]
2014-05-15 changed 16F18XX to low voltage programming mode entry
2014-05-21 --pictype (-p) now case insensitive
2014-06-15 enter ISCP mode only once (for 16F18XX) new command reset_address for pic16 was introduced by this family increased protocol to PROT_UPP3
    [bulk_erase.c, device_table.h, hardware.cpp, hardware.h, main.cpp, read_code.c, read_code.h]
2014-06-16 reverted some parts, kept reset_address for 16F18XX
    [bulk_erase.c, hardware.cpp, hardware.h, main.cpp, read_code.c, read_data.c]
2014-06-17 Added options to limit VPP, disable VDD and limit PGD and PGC to 3.3V
2014-06-19 reverted the driver installer to before 0.6.0, drop win8 support in installer. windows 8 users have to install the driver through zadig (see website)
2014-06-23 in Windows <= 7 install driver, in windows >= 8 open browser with instructions for Zadig
2014-11-29 Fix KiCad link and typo.
2015-04-16 Pull VPP/#RESET down to GND when stopping target.
    Since the most common thing is having a pull-up resistor
    on VPP/#RESET pin, leaving VPP floating doesn't hold the target
    in reset state in case of self-powered targets.
    [hardware.cpp]
2016-06-15 closed issue #6 and #10 (github). Thanks to Diego Herranz for submitting the issues.
    [hexfile.cpp, hexfile.h, pictype.cpp, pictype.h, uppmainwindow.cpp]
2016-08-17 Fixed bug "Data in hex file outside config memory of PIC"
    [hexfile.cpp]
2018-01-22 Fixed compile on ubuntu 17.10
    [hexfile.cpp]
2021-11-08 Update README.md
    https://forum.kicad.info/t/warning-avoid-all-links-to-kicad-pcb-org-use-kicad-org/31521/
2026-09-26 Firmware version: 1.1.0
    Port: `Makefile.xc8` builds from the PIC18Fxxxx device pack; the C18
    code is kept behind `#ifdef`. The USB buffers, bootloader marker and
    vectors sit at the same addresses as in the C18 image. The timer
    variables became `volatile`, without which `DelayMs` could hang under
    XC8.
    Device table: `set_pictype` no longer searches past the end of the
    table. PIC24, dsPIC33 and PIC24EP stay disabled, as you chose.
    LVP entry, no 12 V: new entry routines for 16F18xx/16F150x and the six
    K22 types, based on the confirmed sequences.
    Command loop: replies are never dropped, so the host can't fall one
    reply behind. An aborted multi-block read is cleared. Read and write
    lengths are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
    [bulk_erase.c, bulk_erase.h, device.c, device.h, device_table.h, interrupt.c, interrupt.h, io_cfg.h]
2026-09-27 Firmware 2.0.0: Added in-circuit debugging to usbpicprog
